vinay11hariharan-bit/IM-PULSE/reports/MON-04-M2.pdf

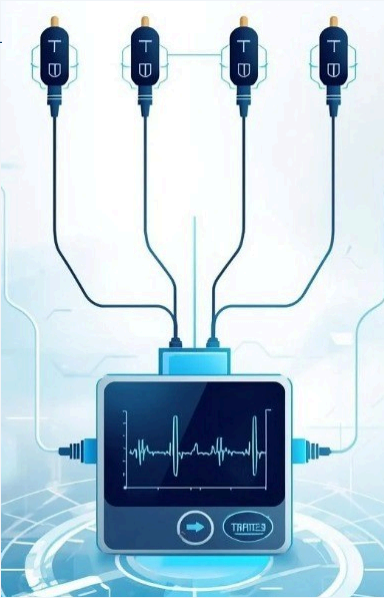
[picture p15: figure]

# Milestone 2

# Simultaneous Measurement of IPGand ECGusing dry Electrodes

# Group ID:MON-04

Team Members- Yashvardhan,

# Krunal, Sudhindra, Vinay,Jahnvi

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
## ple

t

e

d

w

a

s

w

## ell-

received and found to cover most aspects. We were advised to further validate that decisions regarding the number and placement of electrodes are well-justified. Two areas were identified for additional work:Incorporating the necessary interfacing components for the external oscillator Researching appropriate testing methods, as direct testing on humans may not be safe.Feedback

Fin

aliz

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
d: 5

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
al-IP

G

a

c

q

uisitio

n. Included an external oscillato r
alo

n

g

wit

h it

s

r

e

q

uir

e

d interfacing component
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
timin

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
n. Selected a
sin

gle implementation
a

p

p

r

o

a

c

h: chip-based architecture usin g
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
al A

F

E IC

s instead of discrete analog design. Adopted thorax impedance simulator as a testing tool for validating impedance measurement accuracy befor

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
# g. Changes

m

a

d

e

# Gantt chart

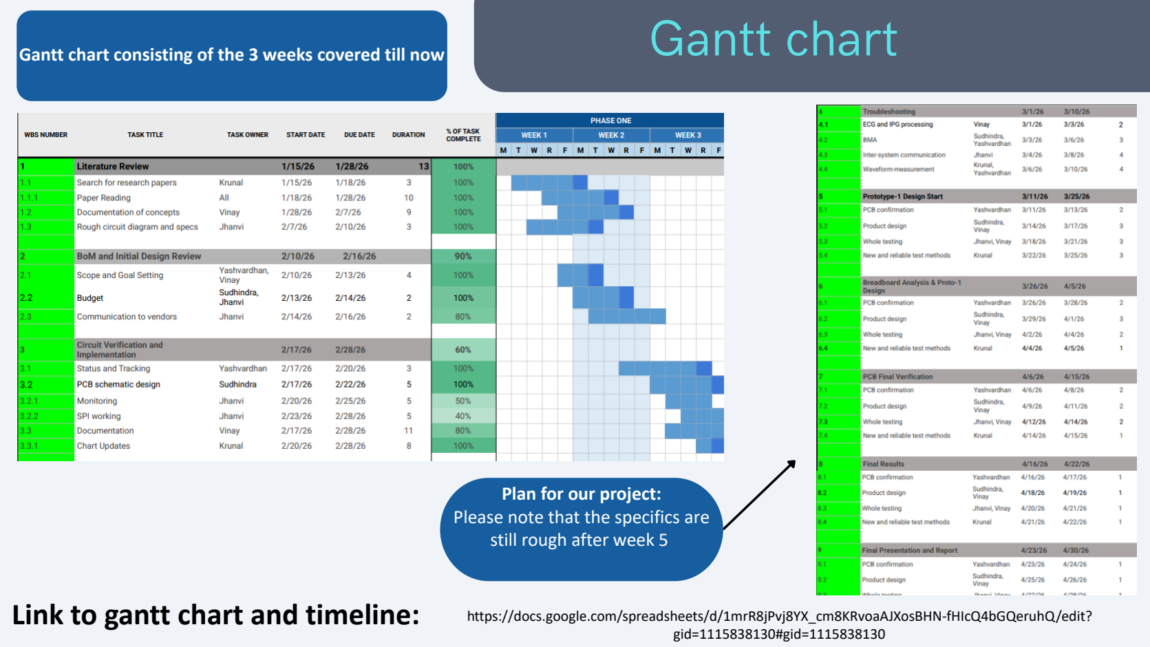
[picture p16: page 3]

Plan for our project:
Please note that the specifics are still rough after week 5

Gantt chart consisting of the 3 weeks covered till now

https://docs.google.com/spreadsheets/d/1mrR8jPvj8YX_cm8KRvoaAJXosBHN-fHIcQ4bGQeruhQ/edit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

## Link to gantt chart and timeline:

# Timeline

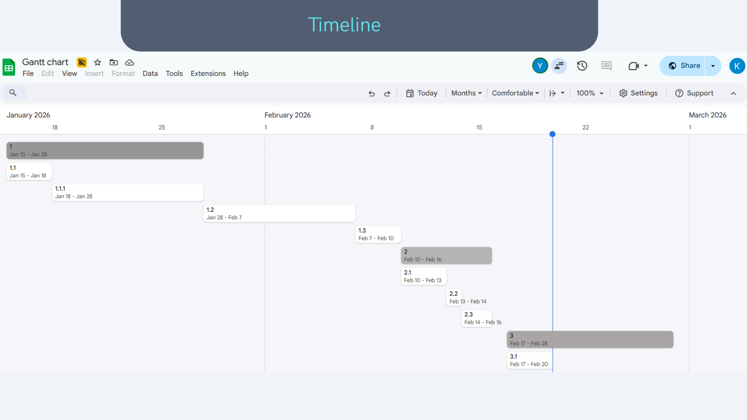
[picture p17: page 4]

# Timeline

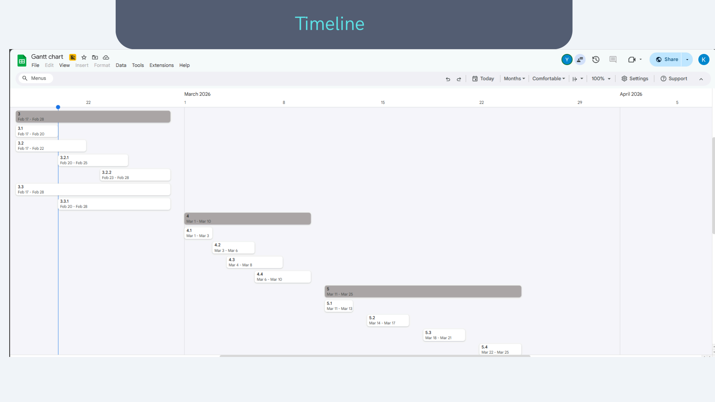
[picture p18: page 5]

# Timeline

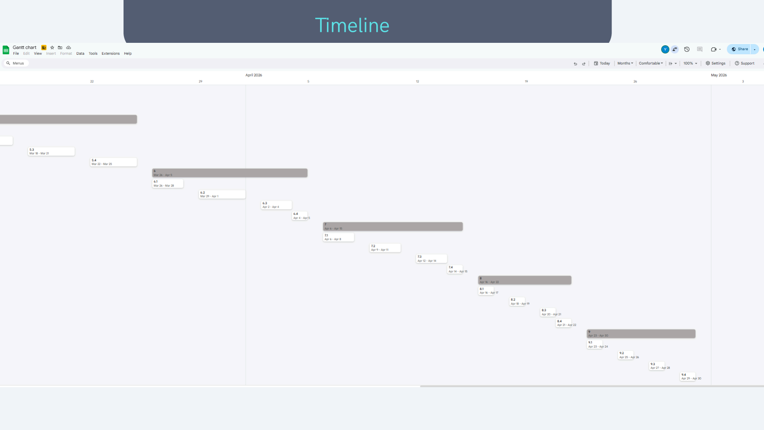
[picture p19: page 6]

Hardware Decisions | Testing Protocol | Accuracy Concerns | Timeline Impact

Our initial design featured four electrodes per chip integrated into a custom PCB. However, following a Bill of Materials (BOM) review with the
research/teaching assistants and Maheshwar Sir, we pivoted away from direct chip integration due to the technical difficulties of soldering BGA (Ball Grid Array) packages. Per their advice, we are now utilizing breakout boards. This modification reduces the available pins to three electrodes per chip (including the RLD drive); consequently, our dual-chip configuration will now utilize a total of five electrodes.

While we originally
intended to conduct
human subject testing, we
have shifted to using a
proxy (e.g., a signal
generator or phantom) to
address safety concerns.
(as suggested by
Himanshu Sir)

Due to simultaneous
current injection and
voltage measurement, the
quality of the measured
IPG signal will also
degrade, as PC Pandey Sir
pointed out to us.

We are currently behind
the original Gantt chart
schedule. The "System-on-Chip" testing phase has
been delayed due to the
late delivery of the
integrated circuits, which are critical components of our system.

# Changes made against gantt chart

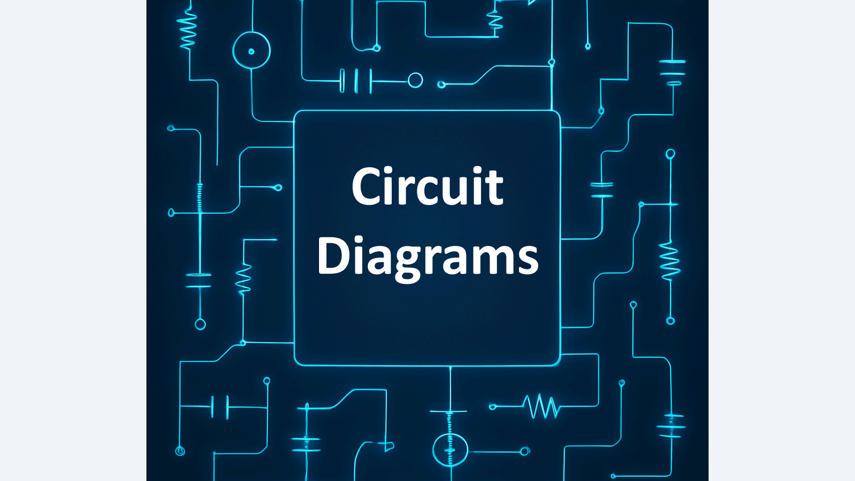
[picture p20: page 8]

# Circuit Diagrams

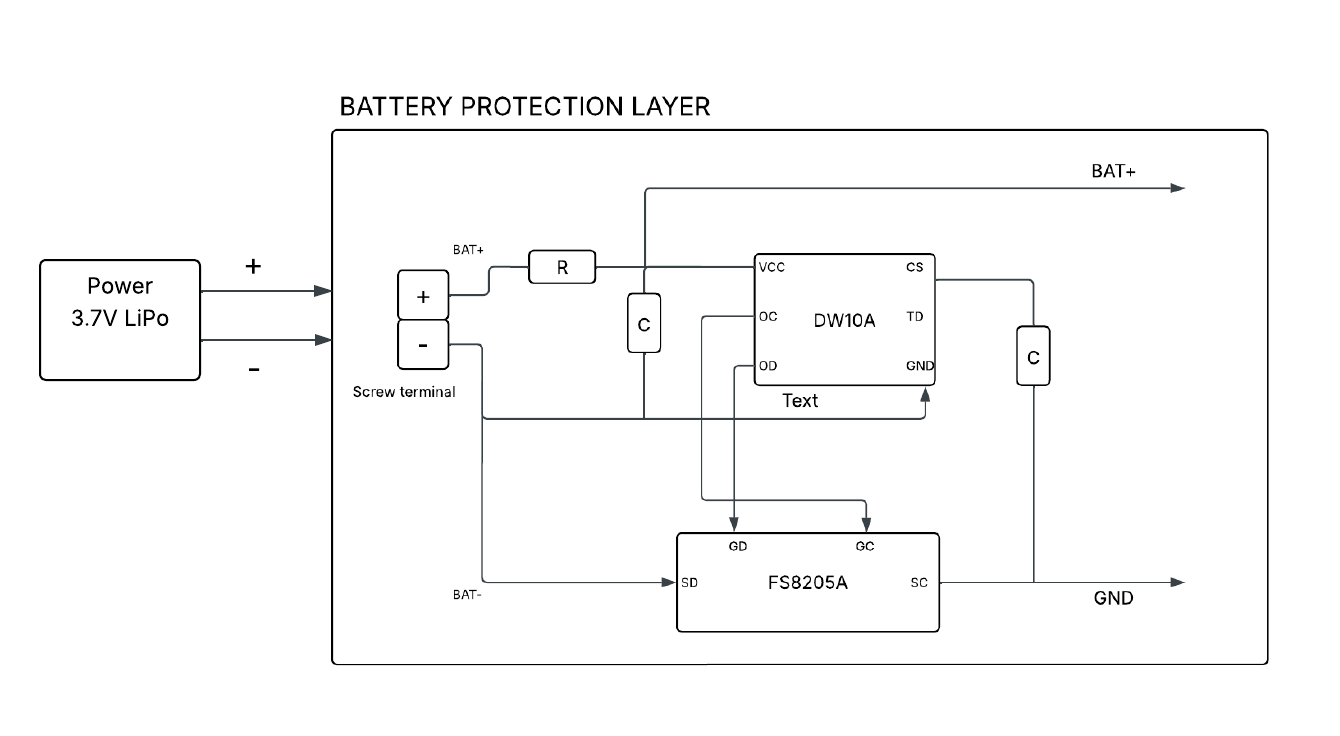
[picture p21: page 9]
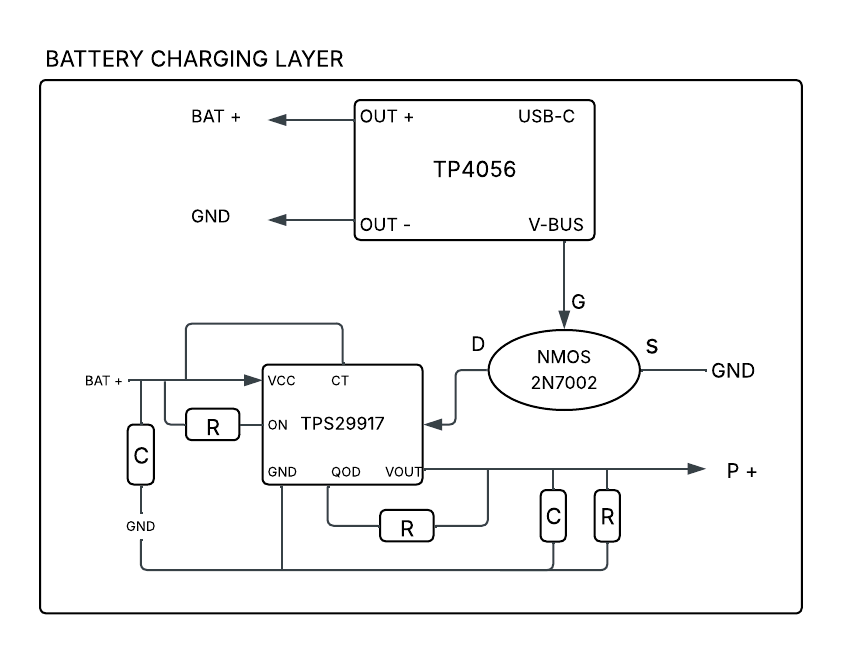
[picture p22: page 10]
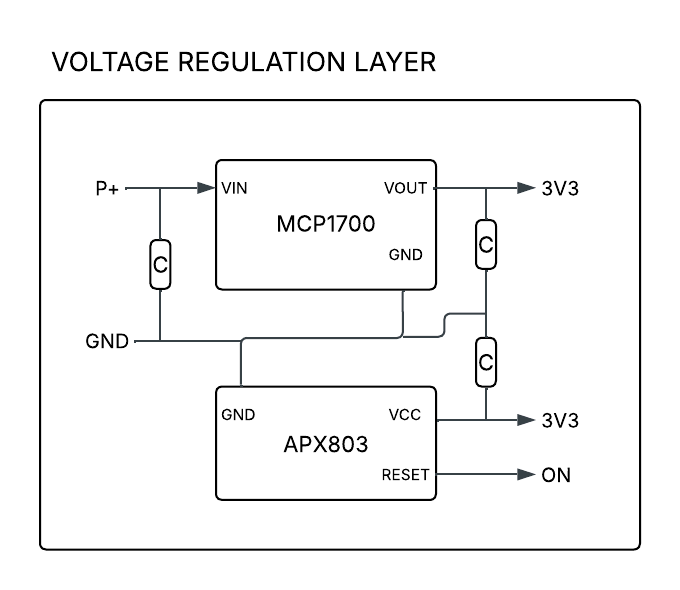
[picture p23: page 11]
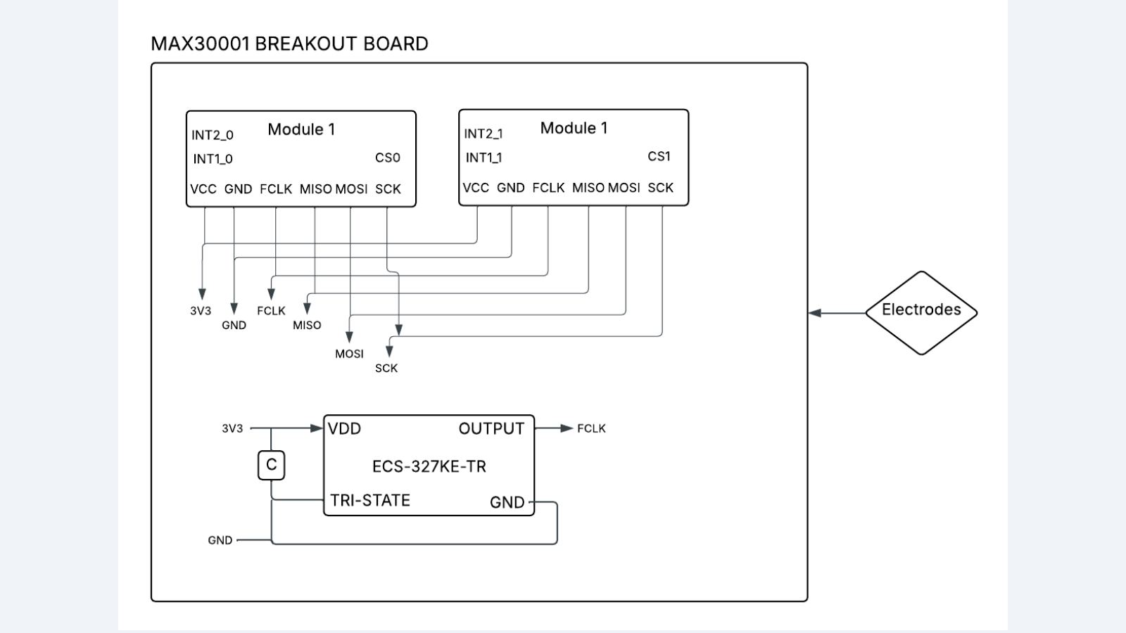
[picture p24: page 12]
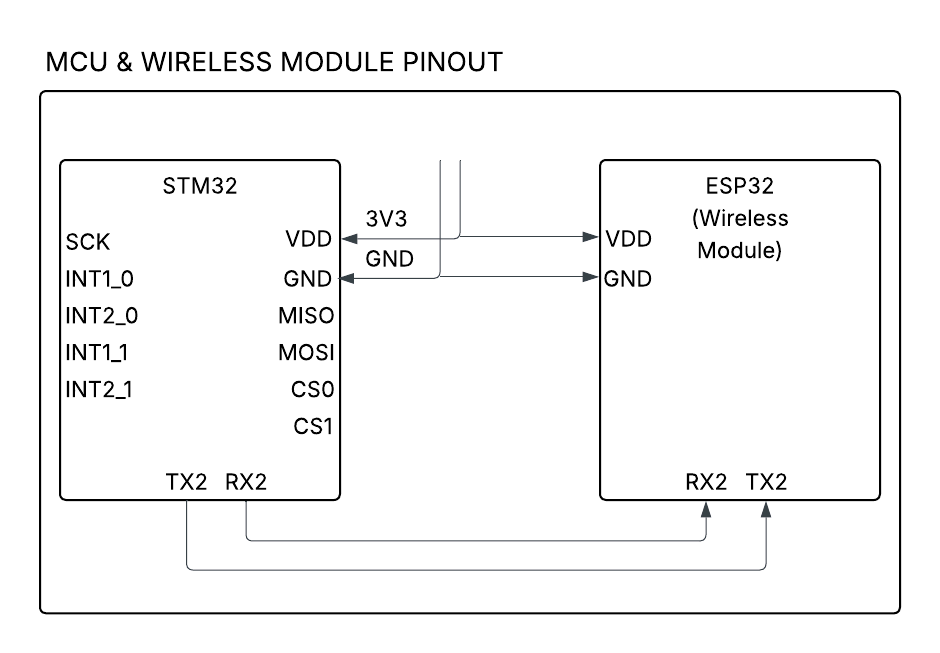
[picture p25: page 13]
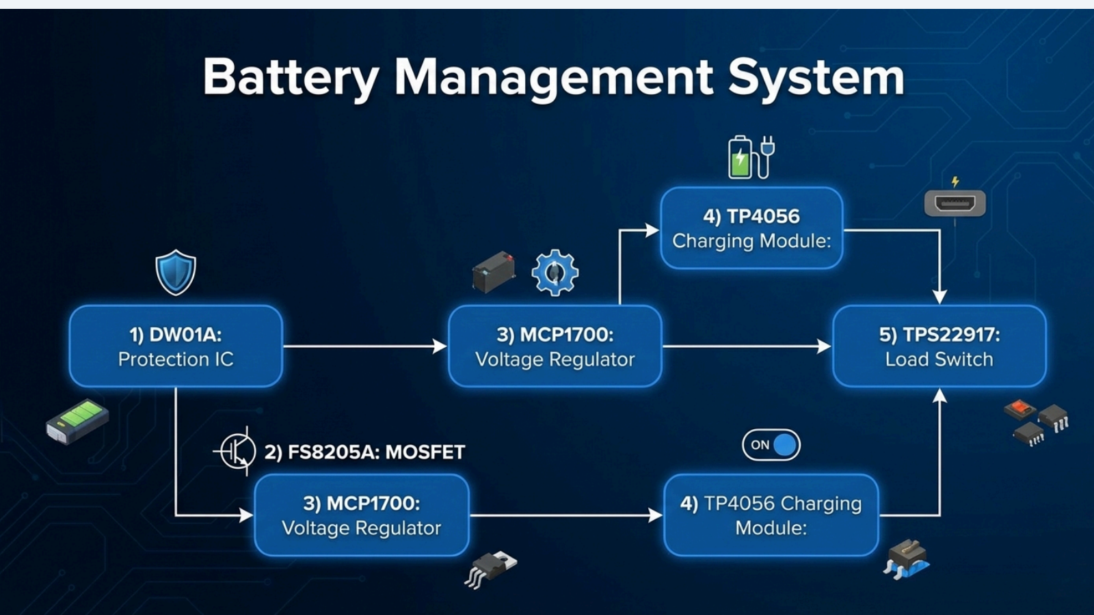
[picture p26: page 14]
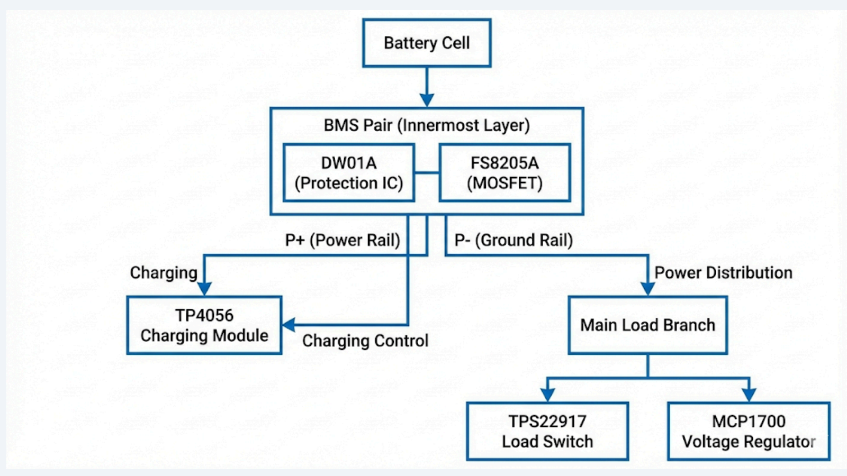
[picture p27: page 15]

# 1) DW01A:

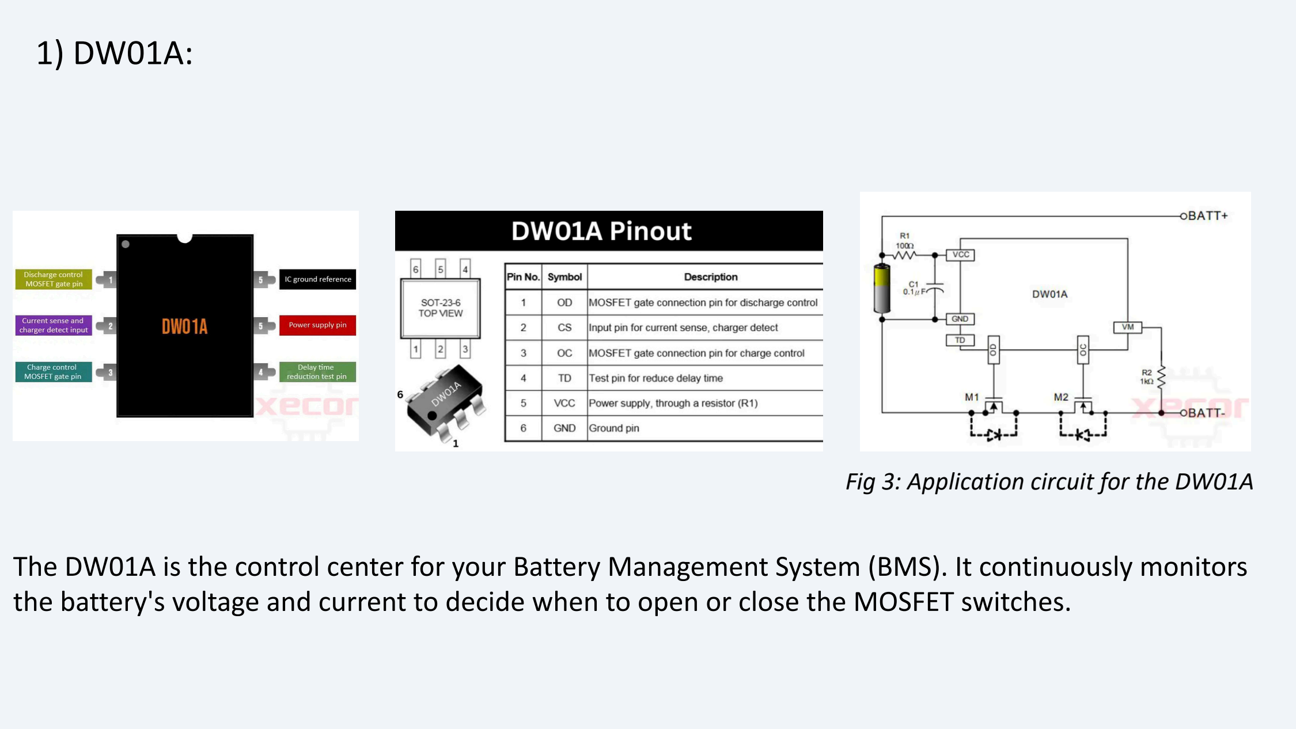
[picture p28: page 16]

The DW01A is the control center for your Battery Management System (BMS). It continuously monitors the battery's voltage and current to decide when to open or close the MOSFET switches.

### Fig 3: Application circuit for the DW01A

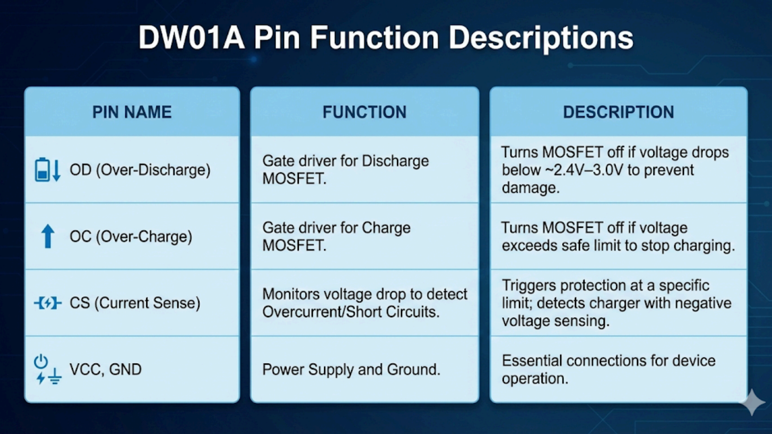
[picture p29: page 17]

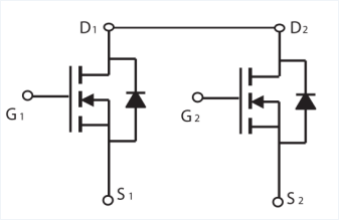
[picture p30: figure]
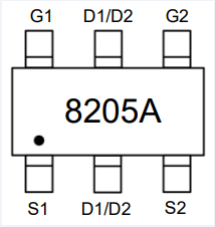
[picture p31: figure]
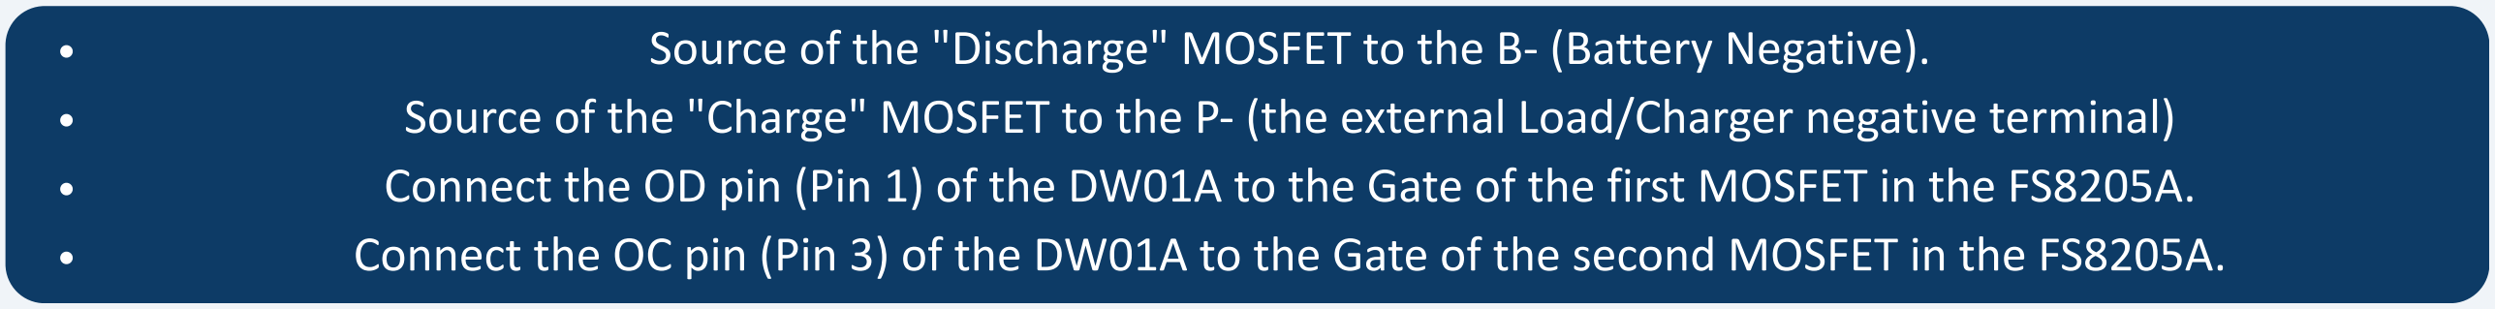
[picture p32: figure]

Source of the "Discharge" MOSFET to the B- (Battery Negative). Source of the "Charge" MOSFET to the P- (the external Load/Charger negative terminal) Connect the OD pin (Pin 1) of the DW01A to the Gate of the first MOSFET in the FS8205A. Connect the OC pin (Pin 3) of the DW01A to the Gate of the second MOSFET in the FS8205A.

# 2) FS8205A:

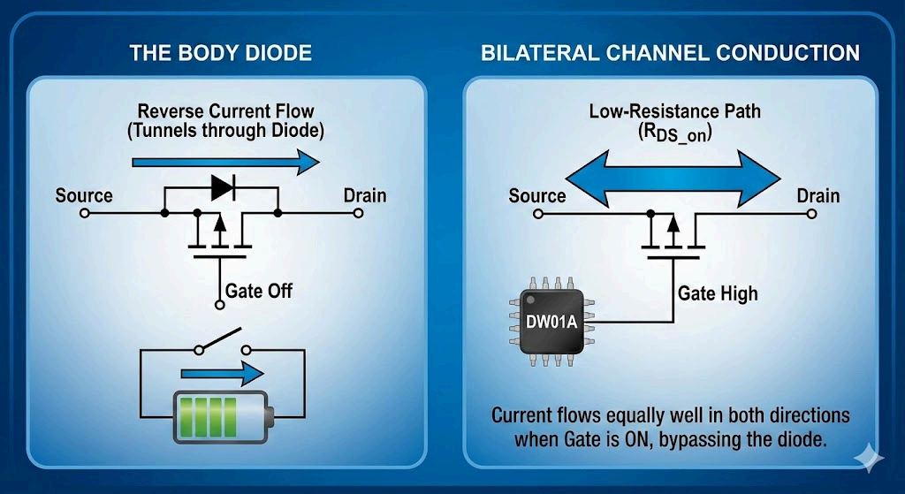
[picture p33: page 19]

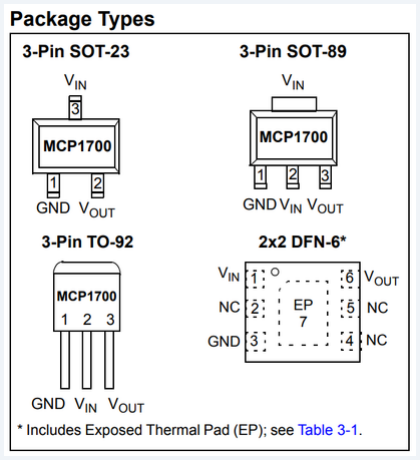
[picture p34: figure]
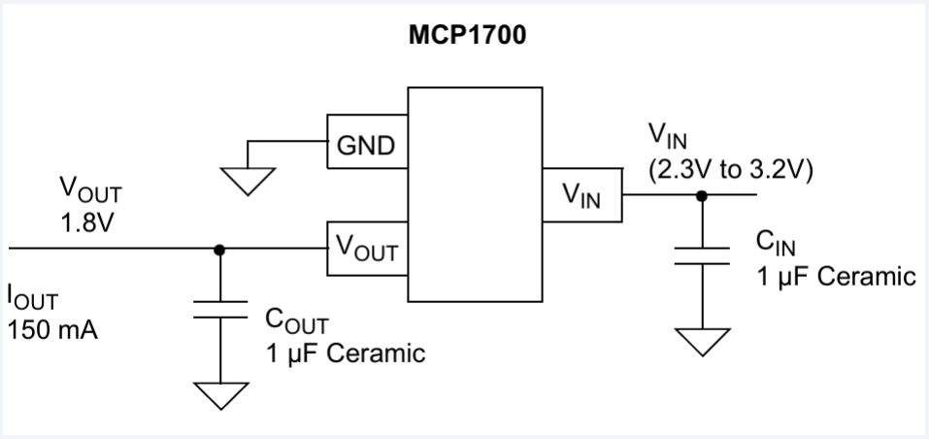
[picture p35: figure]
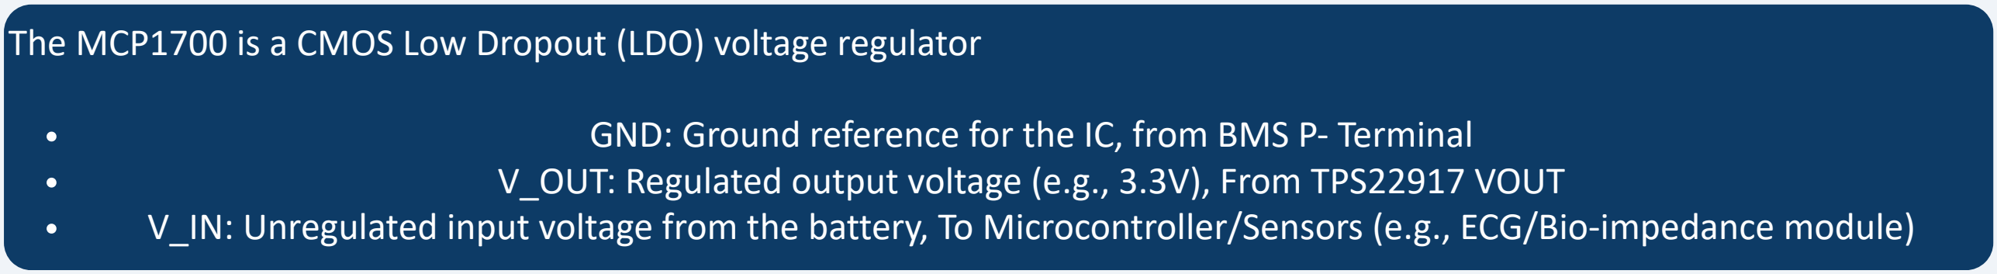
[picture p36: figure]

The MCP1700 is a CMOS Low Dropout (LDO) voltage regulator

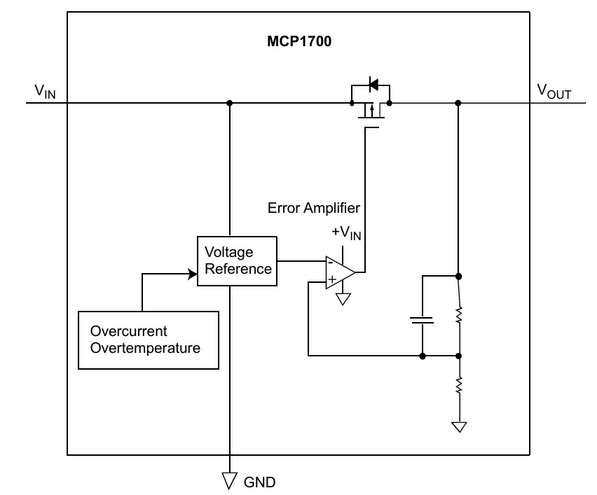
[picture p37: figure]

GND: Ground reference for the IC, from BMS P- Terminal V_OUT: Regulated output voltage (e.g., 3.3V), From TPS22917 VOUT V_IN: Unregulated input voltage from the battery, To Microcontroller/Sensors (e.g., ECG/Bio-impedance module)

## 3) MCP1700:

# 4) TP4056 Charging module:

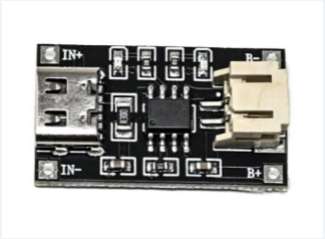
[picture p38: figure]
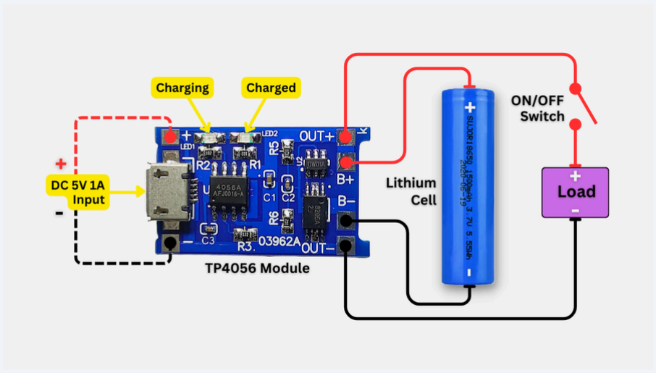
[picture p39: figure]

## Charging Module (TP4056): Connect the BAT+ and BAT- pins of the TP4056 directly to the

P+ and P- terminals the BMS.
Note: Do not connect the TP4056 directly to the battery cell; it must sit "outside" the BMS so the protection IC can cut off the charger if it malfunctions.

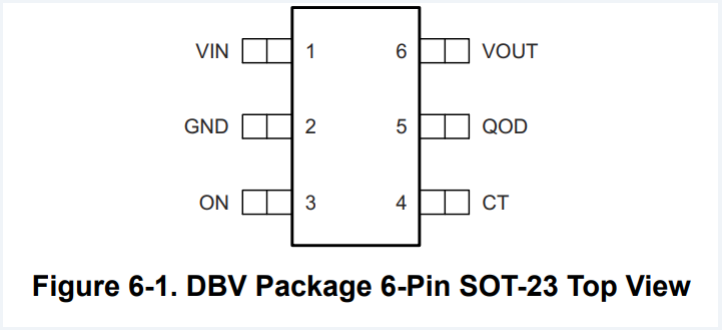
[picture p40: figure]

Implementing the "Disconnect while Charging" Logic

Input Power: Connect P+ (from BMS) to the VIN of the TPS22917.
Control Signal (ON Pin): The TPS22917 "ON" pin is active high. To turn the circuit OFF when a charger is plugged in, we need to "pull down" this pin when voltage is detected at the TP4056 VBUS/USB IN.
Simple Logic: We can use a small NPN transistor or a P-channel MOSFET. Connect the gate/base to the TP4056 input 5V. When 5V is present (charging), the transistor pulls the TPS22917 ON pin to Ground, opening the circuit.
Output to Regulator: Connect the VOUT of the TPS22917 to the VIN of the MCP1700 LDO.

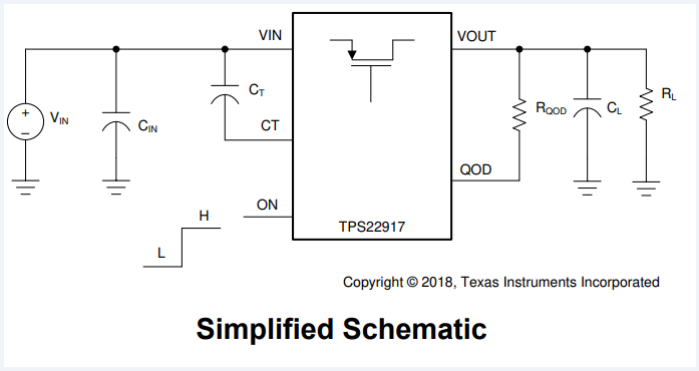
[picture p41: figure]

Description of useful pins: V_OUT: Switched output voltage to the MCP1700 regulator.
GND: Ground reference for the IC.
ON: Active-high enable pin. High = V_{IN} connected to V_{OUT}; Low = Disconnected. V_{IN}: Input voltage from the P+ terminal of the BMS.
CT: Charge Time control. Connect a capacitor here to set the "soft-start" (slew rate).
QOD: Quick Output Discharge. Connect to $V_{OUT}$ to drain the line fast when switched off

## 4) TPS22917:

how to put it in the PCB

# Battery Protection vs. System Stability: The "Brownout Gap"

BMS Cut-off: The DW01A typically cuts power at 2.4V to prevent permanent battery damage.
LDO Dropout: For a 3.3V output, the MCP1700 requires an input of at least ~3.48V due to its dropout voltage.
System Failure: Between 3.4V and 2.4V, the regulator output drops, causing MCU instability, sensor errors, or data corruption in projects like your health monitors or robotic arms.

### 1) Software-Based Monitoring (Internal ADC)

Use a voltage divider to scale the battery voltage and read it via the MCU’s Analog-to-Digital Converter (ADC).
Program a "Soft Cut-off" threshold (e.g., 3.4V).
Allows the MCU to perform a graceful shutdown (saving data to EEPROM or sending a final "Low Battery" alert) before the voltage becomes unreliable.

### 2) Hardware Supervisor (External Reset IC)

Add a dedicated Voltage Supervisor IC (e.g., APX803) to monitor the 3.3V rail.
If the rail dips below a safe threshold (e.g., 3.0V), the supervisor pulls the TPS22917 "ON" pin or the MCU Reset pin low. Provides instant, failsafe protection that does not rely on software logic, ensuring the system never runs in an undefined "glitch" state.

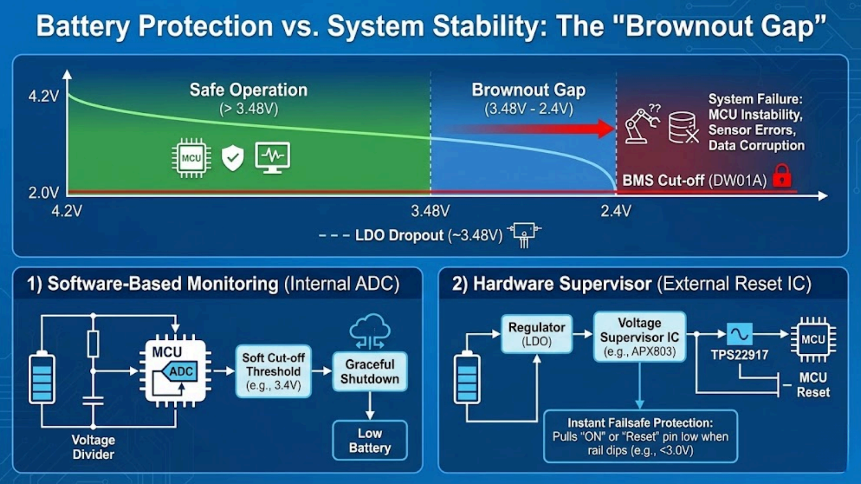
[picture p42: page 24]

## MAX30001 Breakout kit

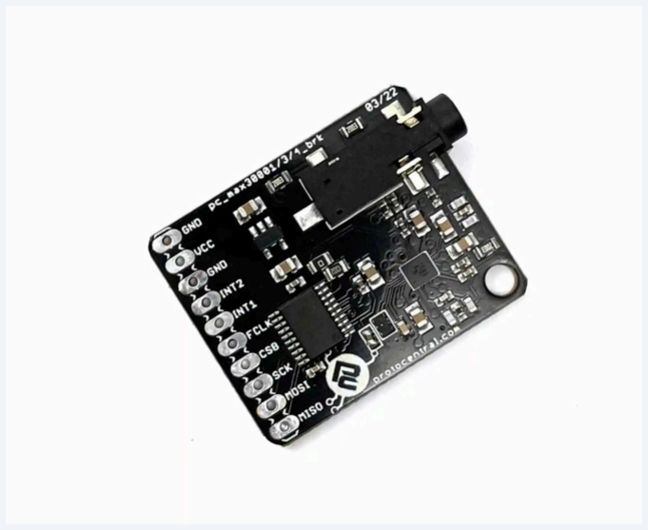
[picture p43: figure]

The MAX30001 is a high-performance Analog Front-End (AFE) designed for clinical-grade ECG and bio-impedance (BioZ) measurements.
VCC: Main analog supply pin. It is typically connected to 5V to power the internal analog circuitry.
3V3: Digital logic supply pin. It connects to a regulated 3.3V rail (for example, from an MCP1700) to match the MCU’s logic levels.
GND: Common ground reference used for both power return and signal reference.
MISO (Master In Slave Out): SPI data output pin. It sends digitized ECG and BioZ data from the MAX30001 to the microcontroller.
MOSI (Master Out Slave In): SPI data input pin. It receives configuration commands and control data from the microcontroller.
SCK (Serial Clock): SPI clock signal. It synchronizes data transfer timing between the MAX30001 and the microcontroller.
CS0 (Chip Select): Active-low SPI select pin. The microcontroller pulls this low to start communication with the MAX30001.
INT1 / INT2: Programmable interrupt output pins. These notify the microcontroller about events such as lead-off detection, FIFO buffer full, or R-to-R heart rate detection.
FCLK: External clock input pin. It allows a precise external frequency reference to be provided if the internal oscillator is not sufficient.

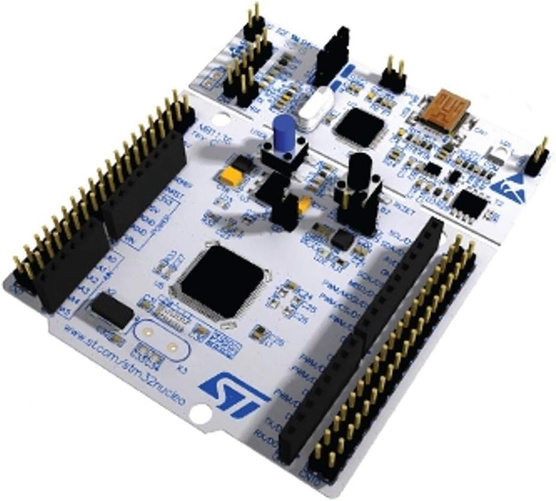
[picture p44: figure]

MAX30001 Pin | Nucleo Connector Pin | STM32 GPIO Pin | Function
VCC | 5V | 5V | Analog Power (5V)
3V3 | 3V3 | 3V3 | Digital Logic (3.3V)
GND | GND | GND | Common Ground
MISO | D12 | PA6 | SPI1 MISO
MOSI | D11 | PA7 | SPI1 MOSI
SCK | D13 | PA5 | SPI1 SCK
CS0 | D10 (or D7) | PB6 | Hardware/Software CS
INT1 | D2 | PA10 | External Interrupt (EXti)

## STM32 Nucleo Board

When configuring the project in STM32CubeIDE,we need to use these settings for the SPI1 peripheral to match the MAX30001 requirements:
Mode: Full-Duplex Master.
Frame Format: Motorola.
Data Size: 8 Bits.
Clock Polarity (CPOL): Low (CPOL = 0).
Clock Phase (CPHA): 1 Edge (CPHA = 0).
Baud Rate: The MAX30001 supports up to 20MHz, but for stable breadboard testing, start around 5-10 MHz.

## ESP32-DEVKIT (Wireless Module)

We would establish a dedicated high-speed data path by cross-connecting STM32 UART2 (TX: PA3/CN10

_

37, RX: PA2/CN10

_

35) to ESP32 UART2 (RX: GPIO16, TX: GPIO17). This configuration isolates the raw medical data stream from the primary USB-to-Serial debug port (UART0 of ESP32).

We bypass the ESP32’s onboard regulator and dropout losses by connecting the regulated 3.3V rail directly to the 3V3 pin instead of the Vin pin.

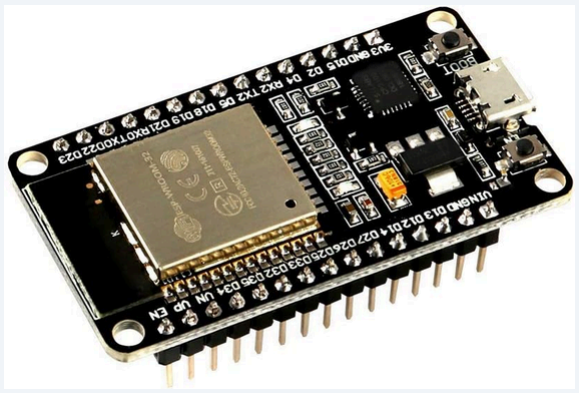
[picture p45: figure]
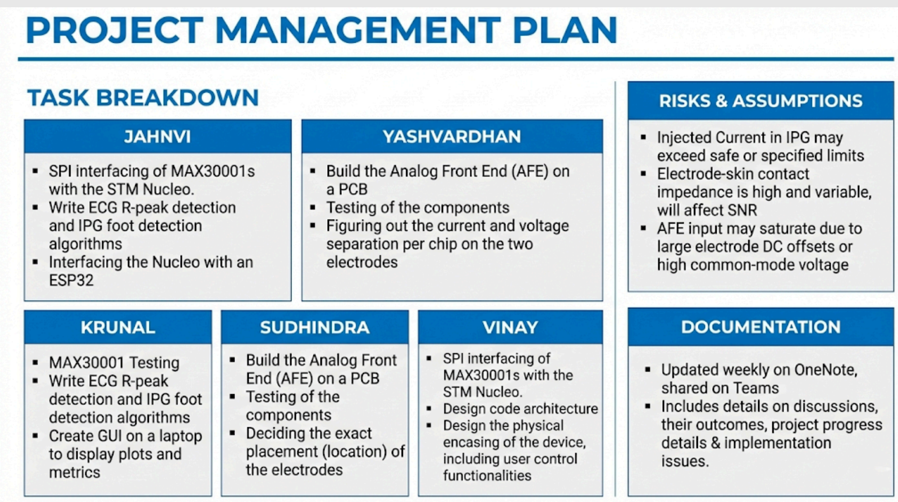
[picture p46: page 28]

# BLOCK DIAGRAM

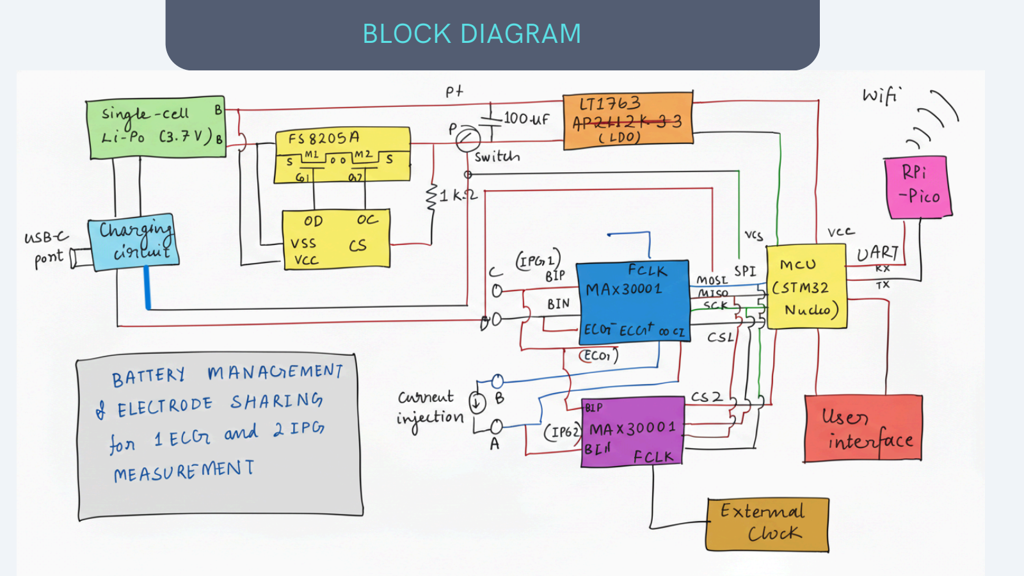
[picture p47: page 29]
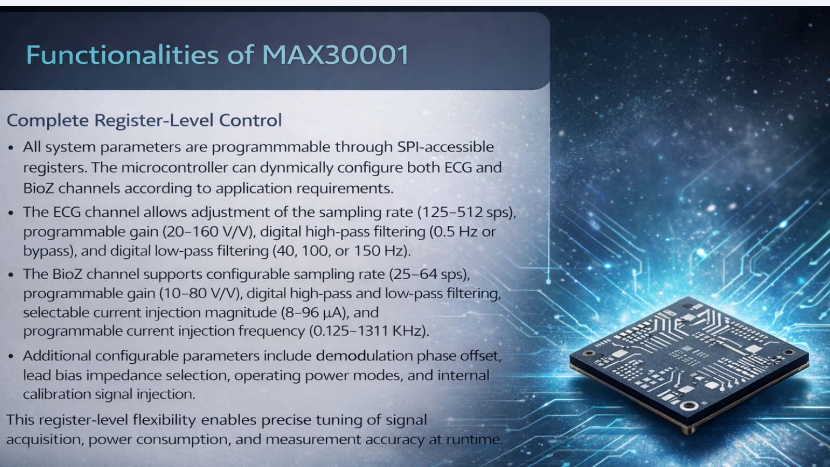
[picture p48: page 30]
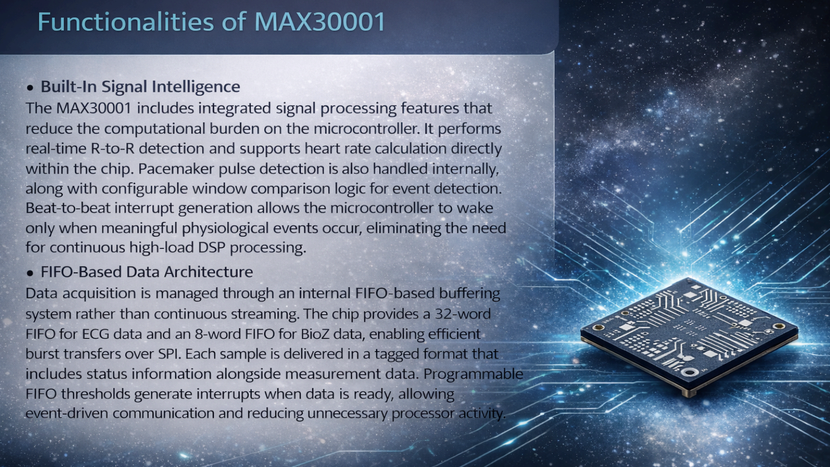
[picture p49: page 31]
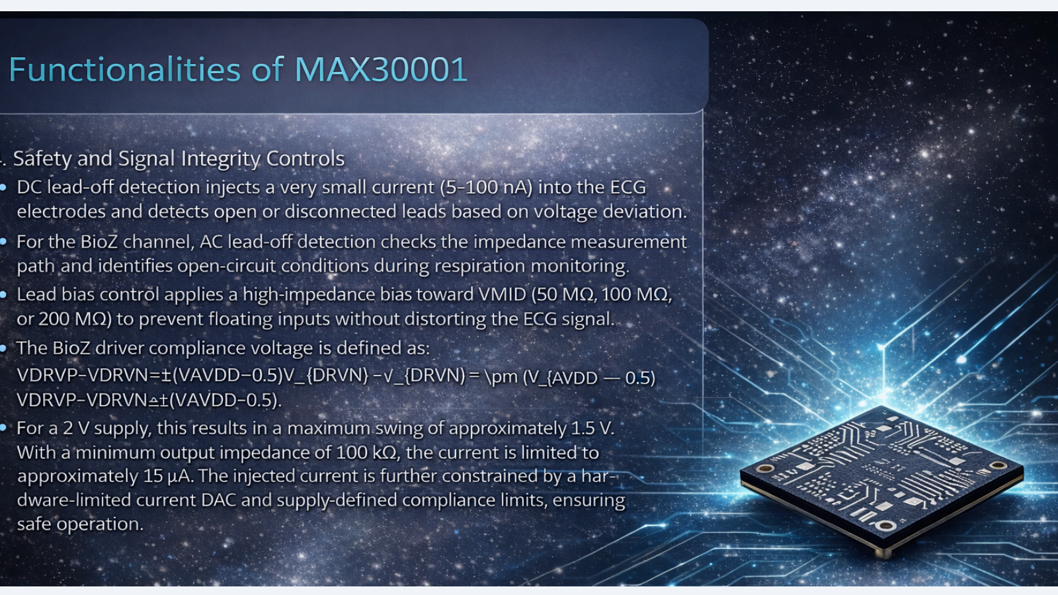
[picture p50: page 32]
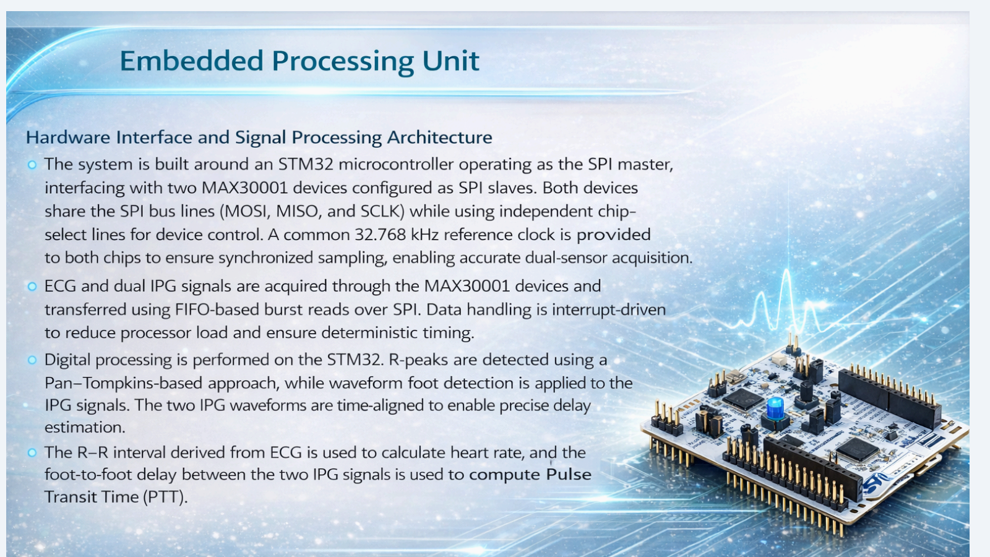
[picture p51: page 33]
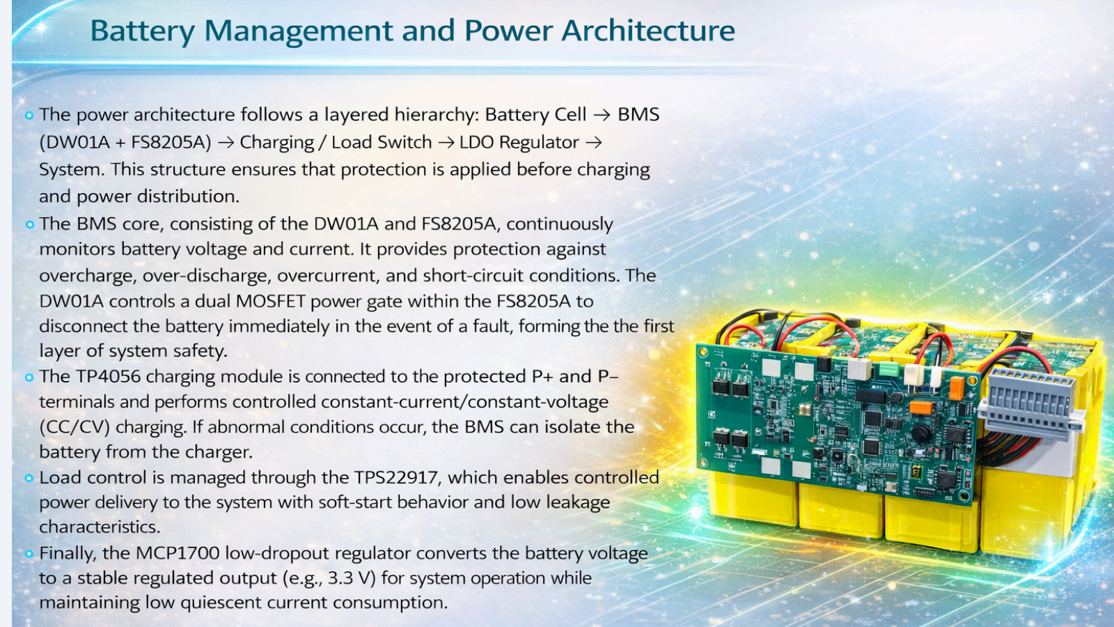
[picture p52: page 34]
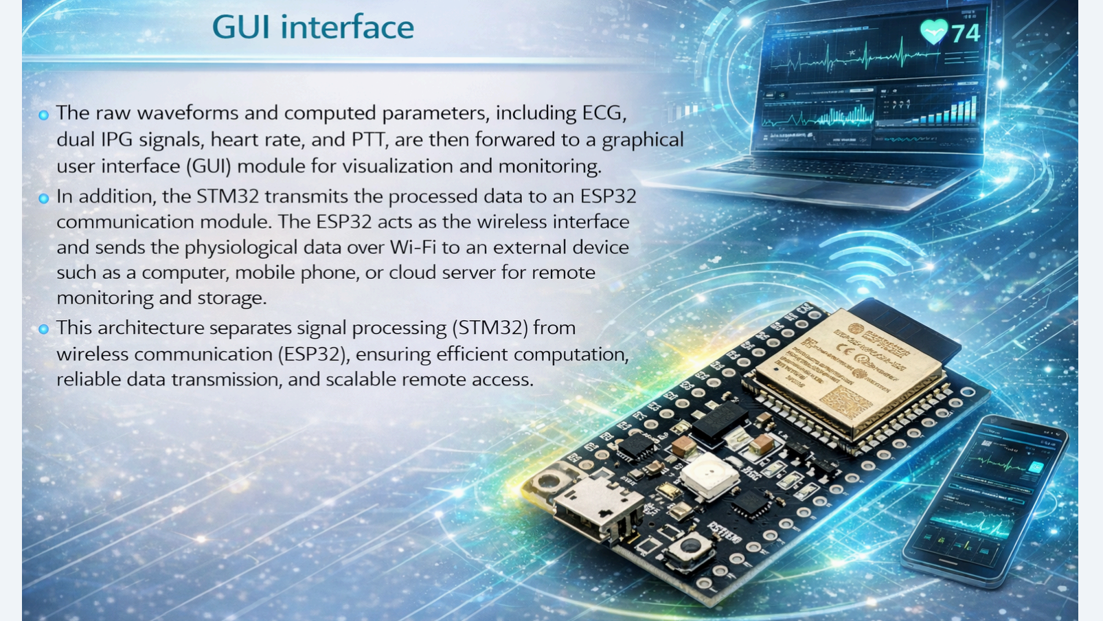
[picture p53: page 35]
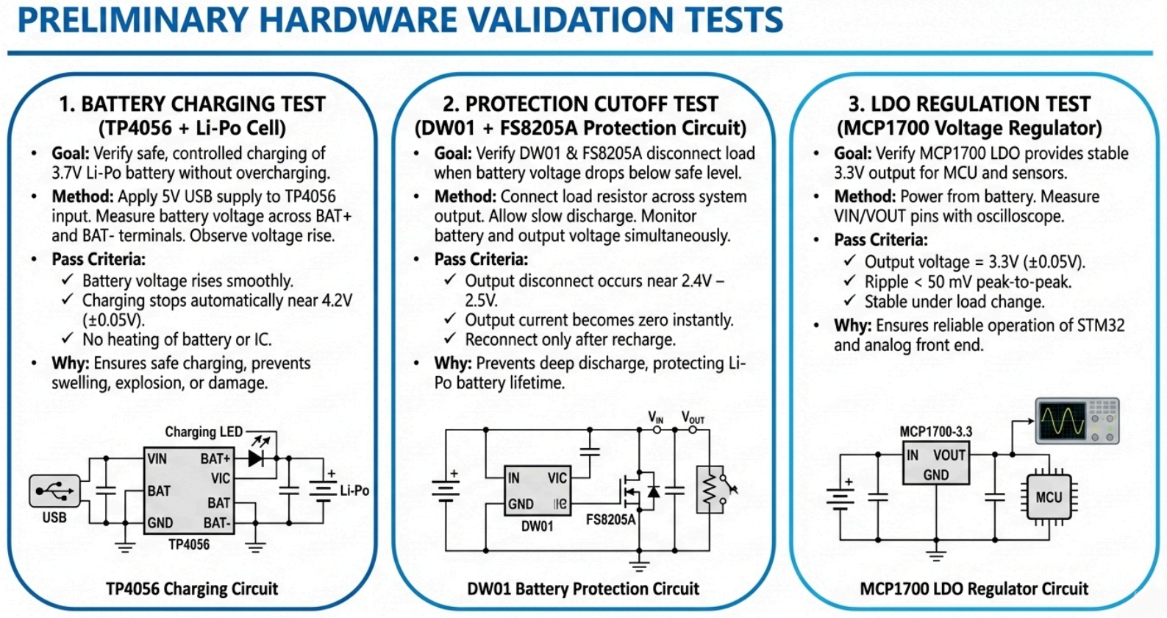
[picture p54: page 36]
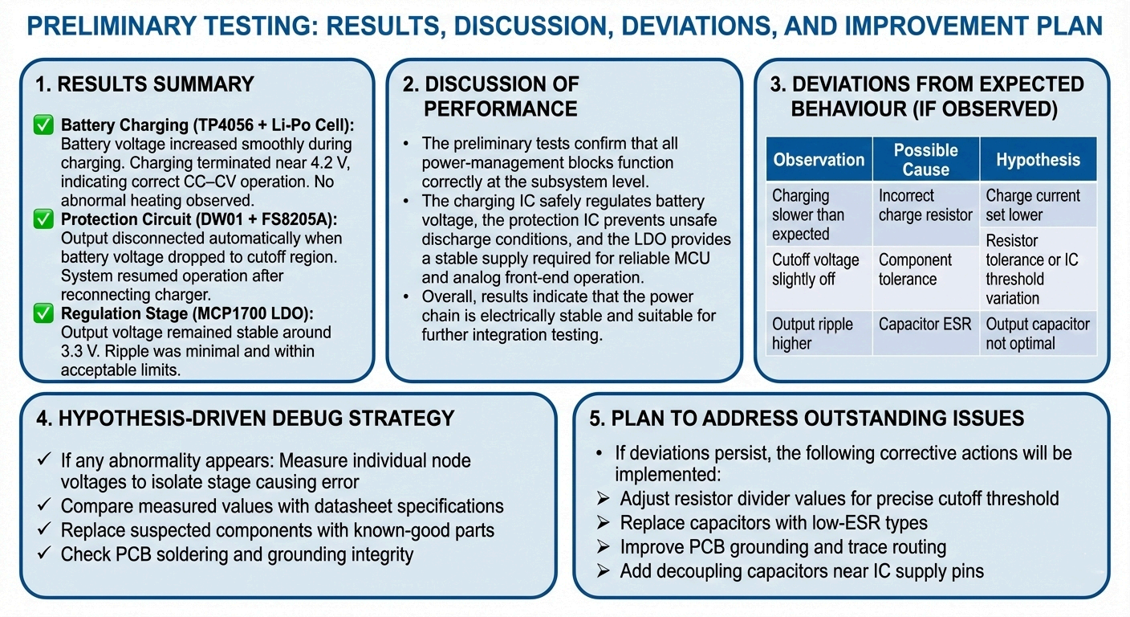
[picture p55: page 37]
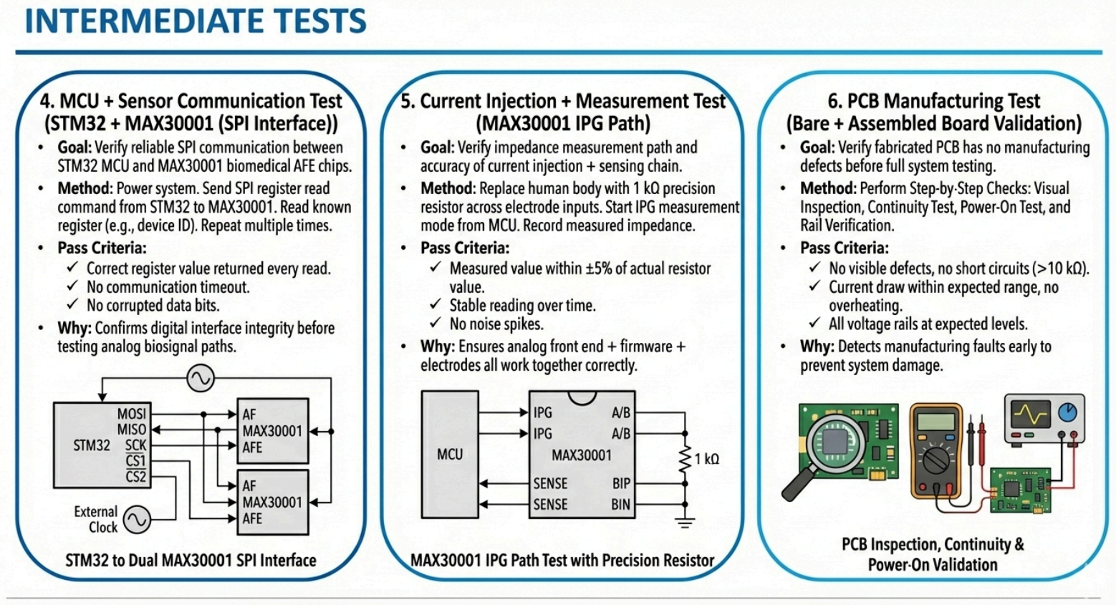
[picture p56: page 38]
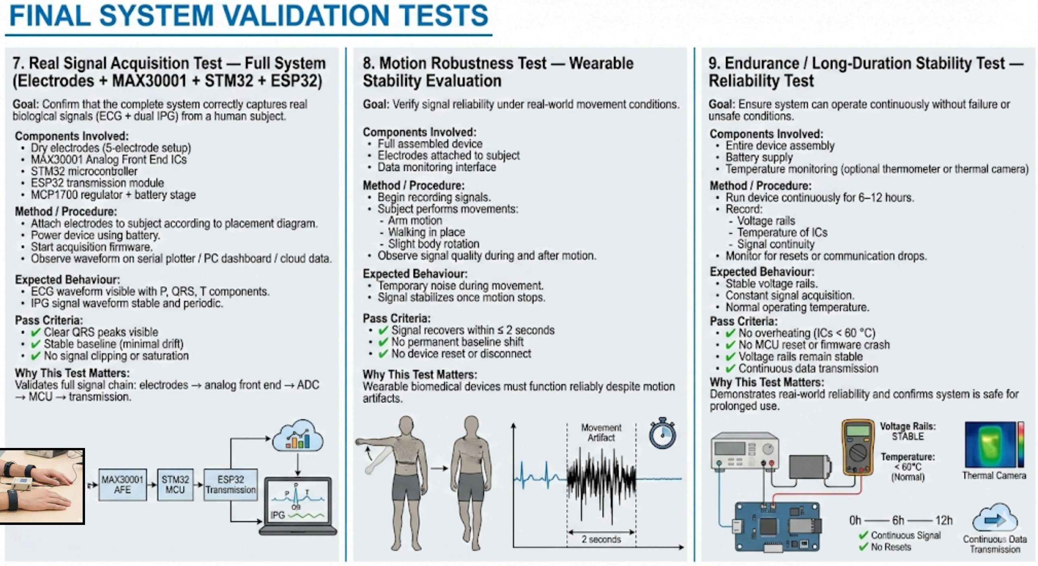
[picture p57: page 39]

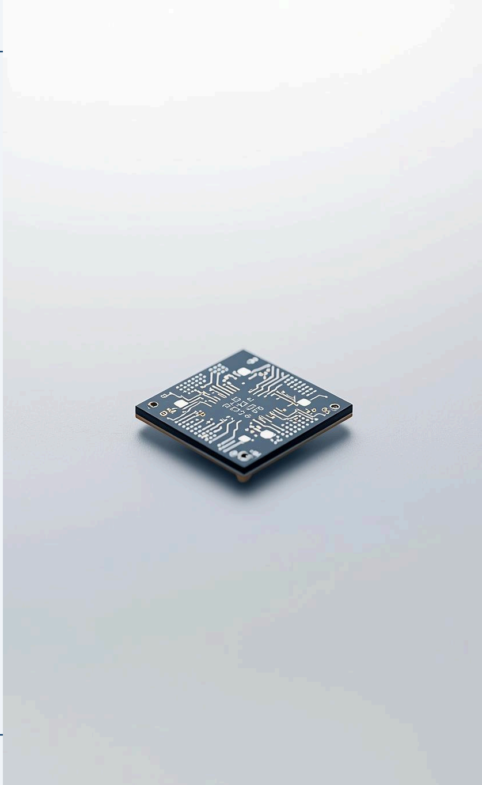
[picture p58: figure]

# Thinking ahead to the nextmilestone

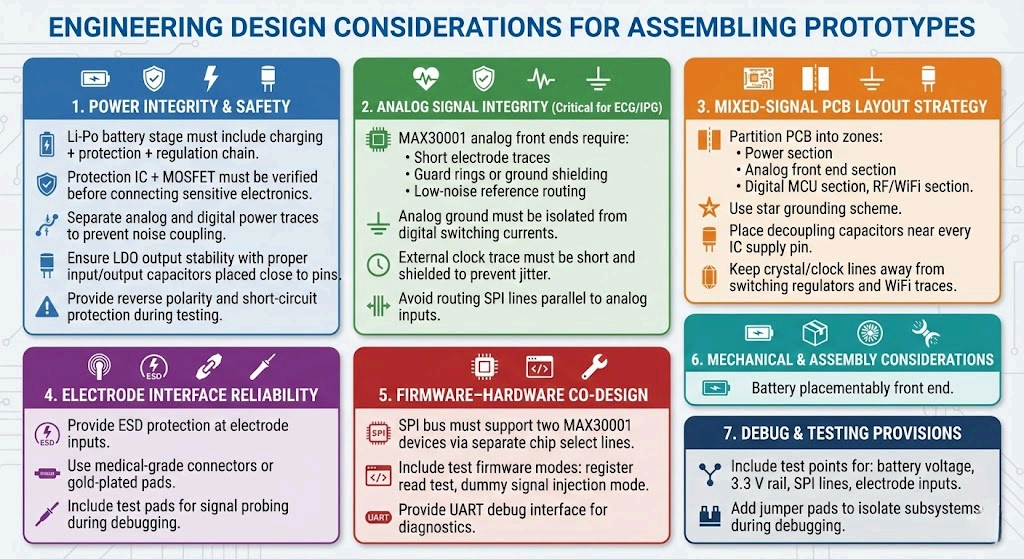
[picture p59: page 41]
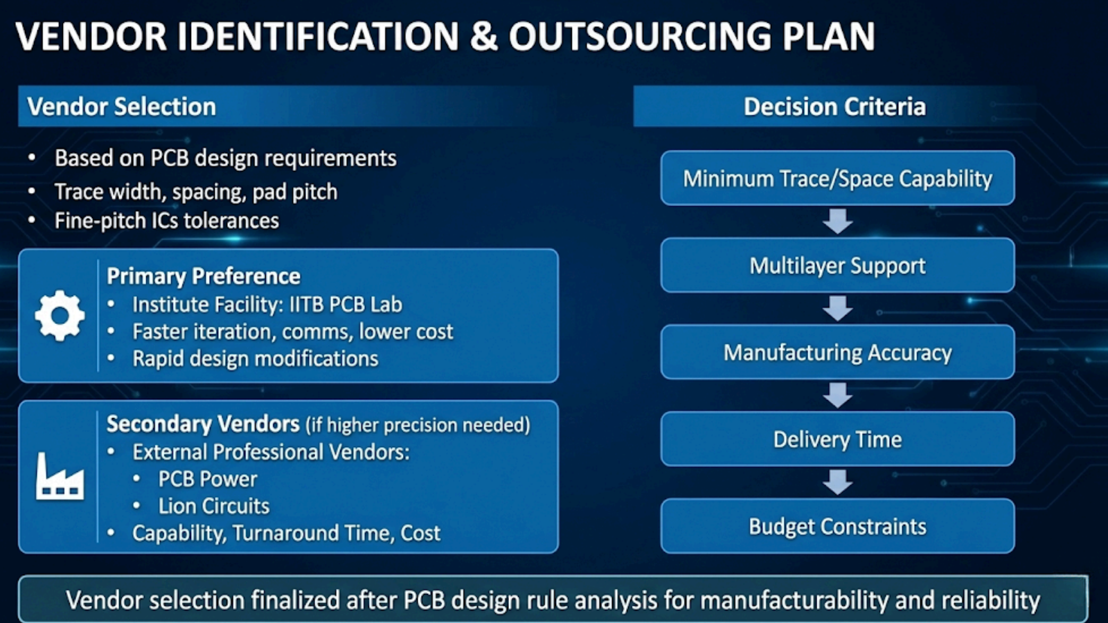
[picture p60: page 42]

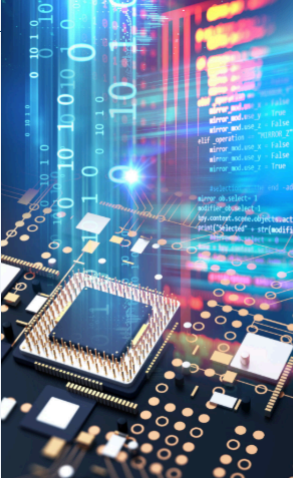
[picture p61: figure]

# SystemSoftware

# Some Design Decisions and Rationale:

## RTOS: ensures deterministic sampling (ECG 256 Hz, IPG 128 Hz), ms-accurate timestamps for PTT, and priority-based execution so acquisition and processing always preempt

communication and UI tasks.

## RTOS Choice (vs Zephyr): selected FreeRTOS for lower RAM/Flash usage, simpler STM32 integration, and sufficient

real-time features without unnecessary complexity.

## No DMA: data transfers are small and interrupt-based drivers

reduce system complexity.

## Logic Analyzer for Debugging: enables verification of SPI timing, chip-select sequencing, and interrupt behavior that

cannot be reliably observed via software debugging alone.

# Code Architecture

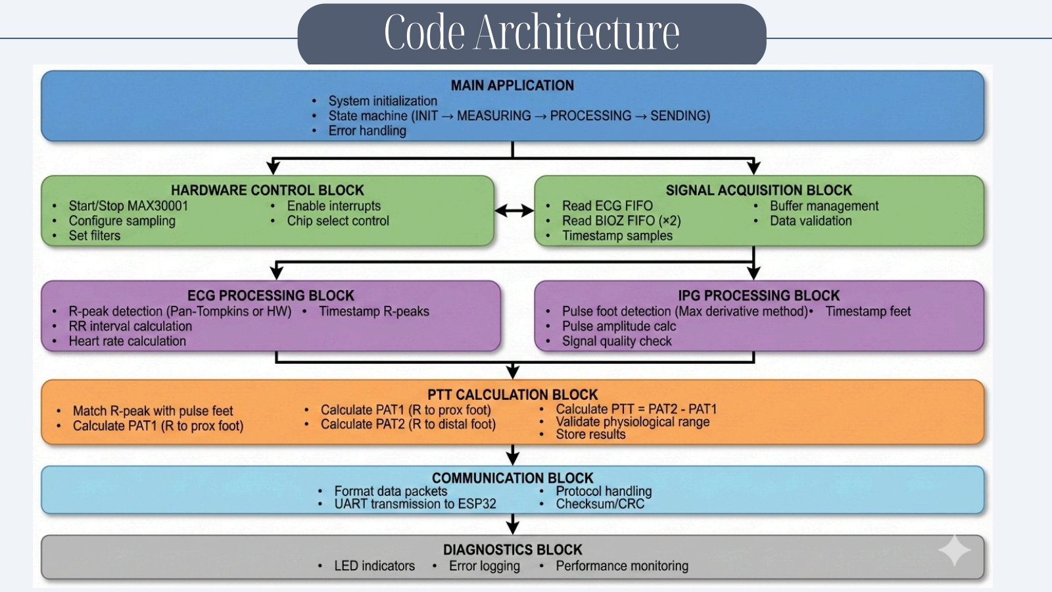
[picture p62: page 44]

# Simulation:R-peak detectionalgorithm

## The algorithm is a linear signal processing pipeline in which each stage

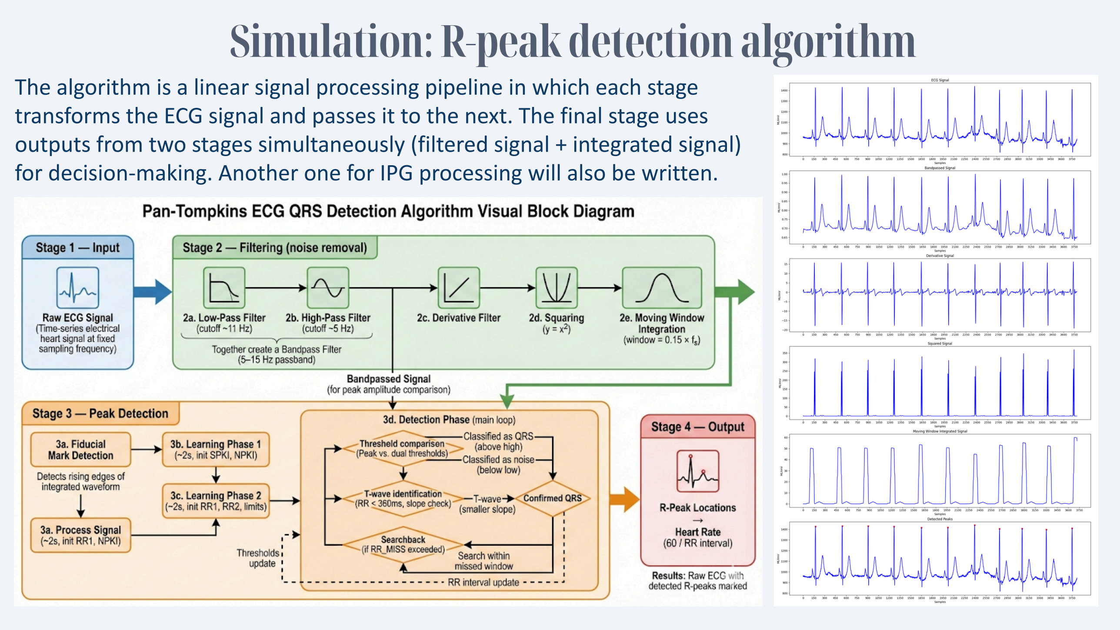
[picture p63: page 45]

## transforms the ECG signal and passes it to the next. The final stage uses outputs from two stages simultaneously (filtered signal + integrated signal)

for decision-making. Another one for IPG processing will also be written.

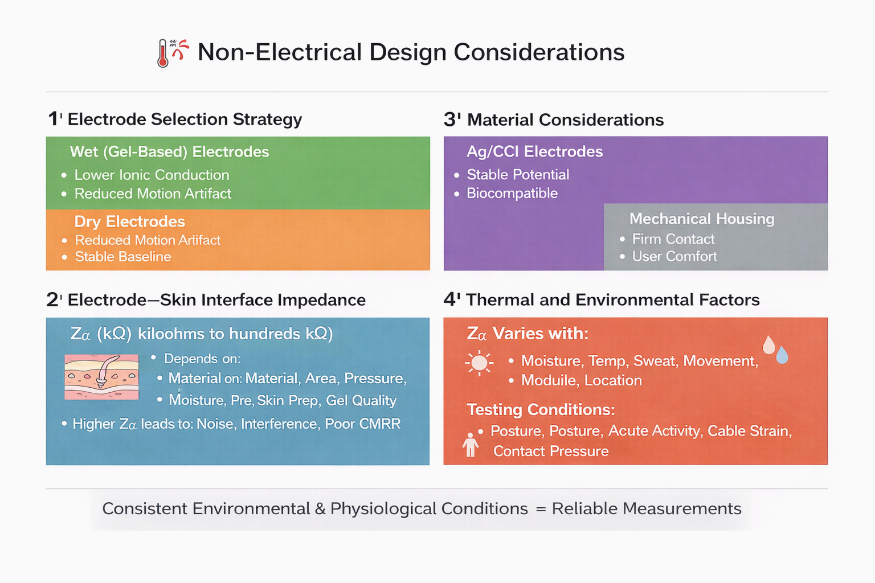
[picture p64: page 46]
