vinay11hariharan-bit/IM-PULSE/others/extra/xgbreg.pdf

## XGBRegressor vs Linear Regression

## XGBRegressor Overview

XGBRegressor (eXtreme Gradient Boosting Regressor) is an efficient implementation of the gradient boosted decision tree algorithm designed specifically for regression tasks. It is part of the XGBoost library, which is widely used in machine learning due to its speed and high performance.

## How it Works

XGBoost is an ensemble method. Instead of fitting a single model to the data, it builds a sequence of simple models (typically decision trees) iteratively:

- The first tree makes an initial rough prediction.
- The second tree focuses on correcting the errors (residuals) of the first tree.
- The third tree focuses on the remaining errors of the previous trees.
- This process continues, with each new tree improving the overall prediction.

## Key Differences from Linear Regression

When referring to “normal” regression, it typically means Ordinary Least Squares (OLS) Linear Regression. The key differences are summarized below:

Feature | Linear Regression (Normal) | XGBRegressor
Relationship | Assumes a linear relationship be-
tween inputs and outputs.

Captures complex, non-linear relationships and feature interactions.
Complexity | High bias (simple model); may
underfit complex data.

High variance (complex model); may overfit if not tuned properly.
Outliers | Highly sensitive to outliers. | More robust to outliers due to
tree-based splitting.
Feature Scaling | Requires feature scaling (e.g.,
normalization) for optimal performance.
Invariant to | feature | scaling;
works well with raw data.

Handling Missing
Data

Cannot handle missing values directly; requires imputation.

Handles missing values automatically using sparsity-aware splitting.
Regularization | Requires | separate | techniques
(Ridge/Lasso) to prevent over-
| fitting.

Includes built-in L1 and L2 regularization.

## When to Use Which?

Use Linear Regression if:

- Interpretability is important.
- You need to understand the exact contribution of each feature.
- The relationship between variables is approximately linear.

Use XGBRegressor if:

- The dataset is large and complex.
- There are non-linear relationships and feature interactions.
- The data contains missing values.
- The primary goal is high prediction accuracy.

## Mathematical Formulation of XGBRegressor

XGBoost models the prediction as an additive ensemble of decision trees. Given a dataset with n samples and m features, the predicted output for the i

th sample is:

yˆi =

X

K

k=1

fk(xi), | fk ∈ F | (1)

where:

- K is the number of trees,
- fk represents an individual regression tree,
- F is the space of all possible trees.

Objective Function

The model is trained by minimizing a regularized objective function:

L =

Xn

i=1

l(yi

, yˆi) + X

K

k=1

Ω(fk) | (2)

where:

## - l(yi

, yˆi) is the loss function (e.g., squared error),
- Ω(fk) is the regularization term controlling model complexity.

Regularization Term

The regularization term for a tree is defined as:

Ω(f) = γT +

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
where:

- T is the number of leaves in the tree,
- wj is the weight of leaf j,
- γ controls the complexity (penalty on number of leaves),
- λ is the L2 regularization parameter.

Additive Training (Boosting)

XGBoost builds the model in an additive manner. At iteration t, the prediction is updated as:

yˆ

(t)
i = ˆy

(t−1)
i | + ft(xi) | (4)

To optimize efficiently, the loss is approximated using a second-order Taylor expansion:

L

(t) ≈

Xn

i=1

gift(xi) + 1
2

hif

2
t

(xi)

+ Ω(ft) | (5)

where:

gi =

∂l(yi
, yˆ

(t−1)
i

)

∂yˆ

(t−1)
i

, hi =

∂

2
l(yi
, yˆ

(t−1)
i

)

∂(ˆy

(t−1)
i

)

2

(6)

Optimal Leaf Weights

For a given tree structure, the optimal weight of leaf j is:

w

∗
j = −

P
i∈Ij

gi
P
i∈Ij

hi + λ

(7)

where Ij is the set of samples in leaf j.

Split Gain

The quality of a split is measured using the gain:

Gain =

1
2

"
(

P gL)

2
P hL + λ

+

(

P gR)

2
P hR + λ

−

(

P g)

2
P h + λ
− γ | (8)

where:

- L and R denote left and right child nodes,
- g and h are gradients and Hessians.

Summary

XGBoost improves prediction accuracy by:

- Sequentially adding trees to correct residual errors,
- Using second-order optimization (gradient + Hessian),
- Applying regularization to prevent overfitting,
- Optimizing tree splits using a gain-based criterion.
