vinay11hariharan-bit/IM-PULSE/3d_models/elec_box/cad_front_face.png

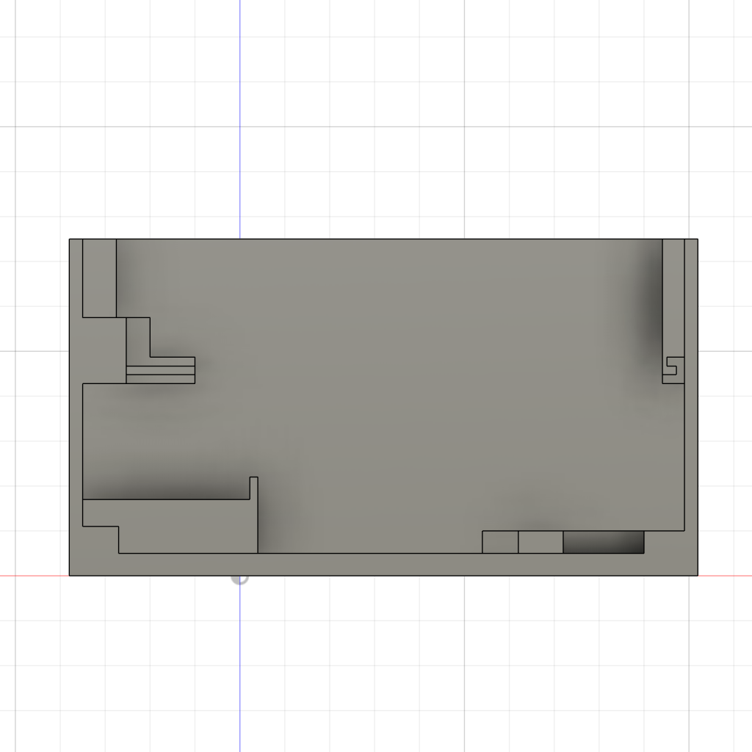
3d_models/elec_box/cad_front_face.png
