vinay11hariharan-bit/IM-PULSE/3d_models/elec_box/cad_right_face.png

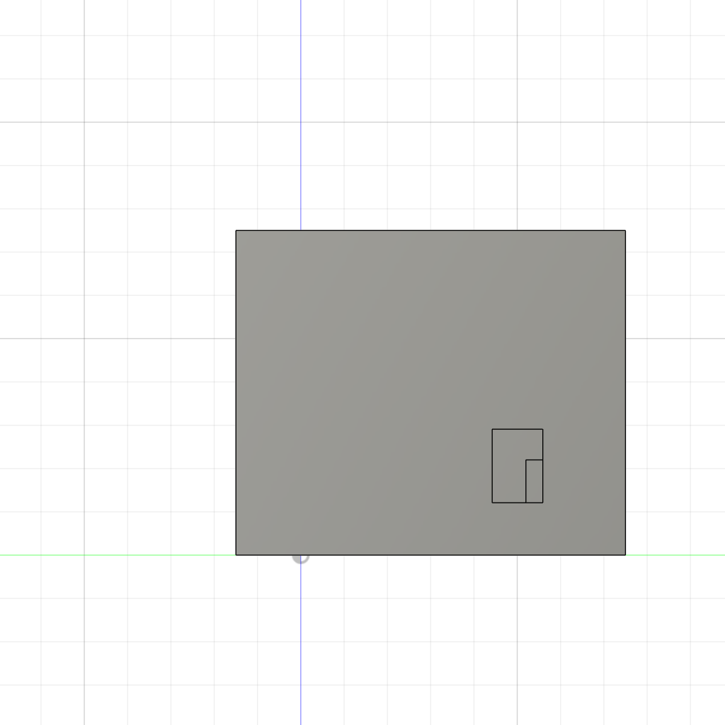
3d_models/elec_box/cad_right_face.png
