vinay11hariharan-bit/IM-PULSE/3d_models/elec_box/cad_top.png

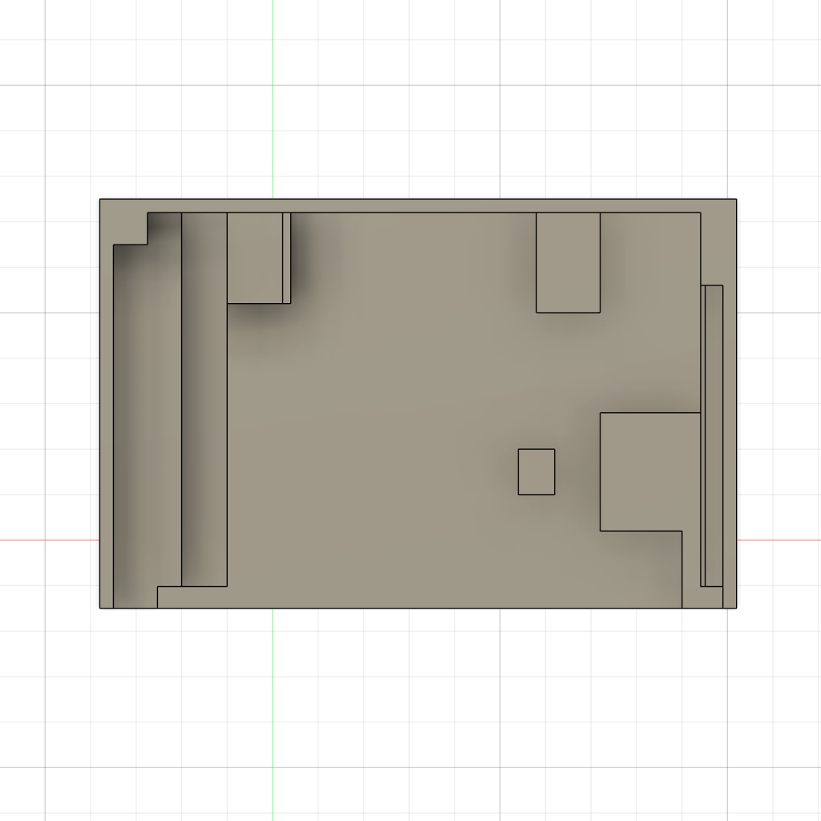
3d_models/elec_box/cad_top.png
