vinay11hariharan-bit/IM-PULSE/others/extra/BMS_documentation/BMS_flowchart.jpeg

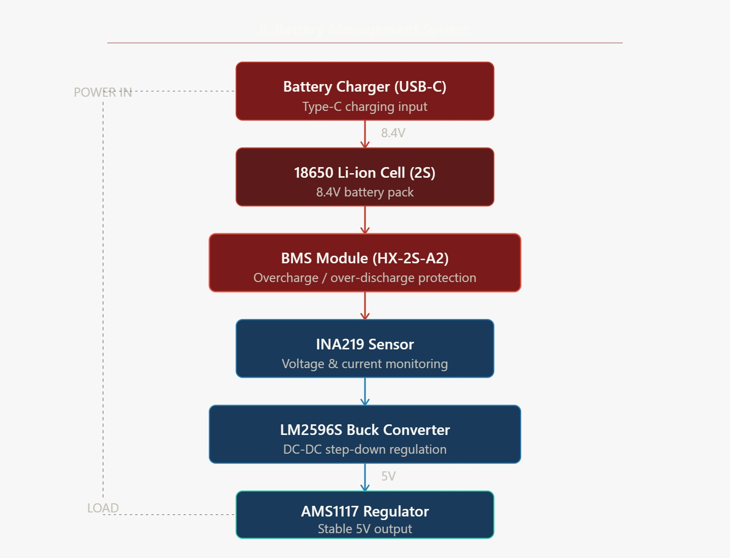
others/extra/BMS_documentation/BMS_flowchart.jpeg
