vinay11hariharan-bit/IM-PULSE/others/images/inter_pcb_connection.jpeg

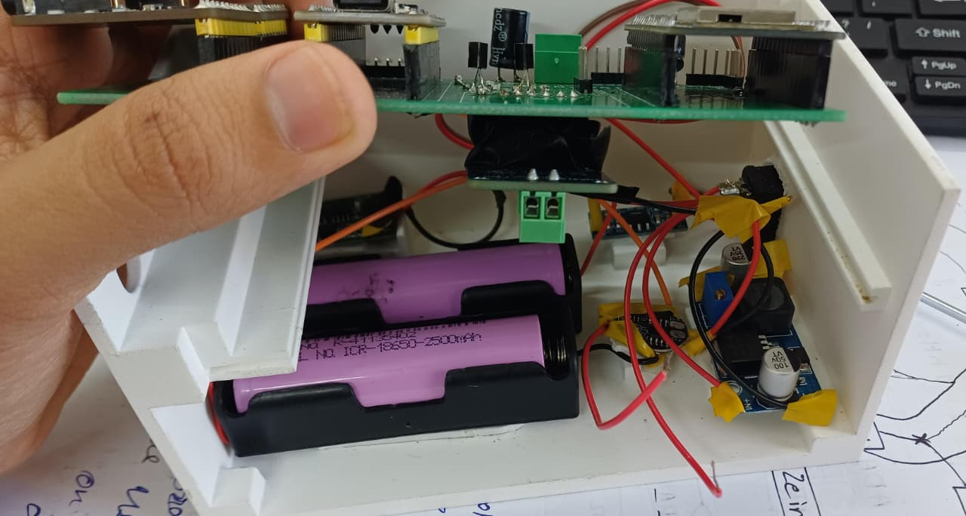
others/images/inter_pcb_connection.jpeg
