vinay11hariharan-bit/IM-PULSE/pcb/device_pcb/bottom_copper_layer.png

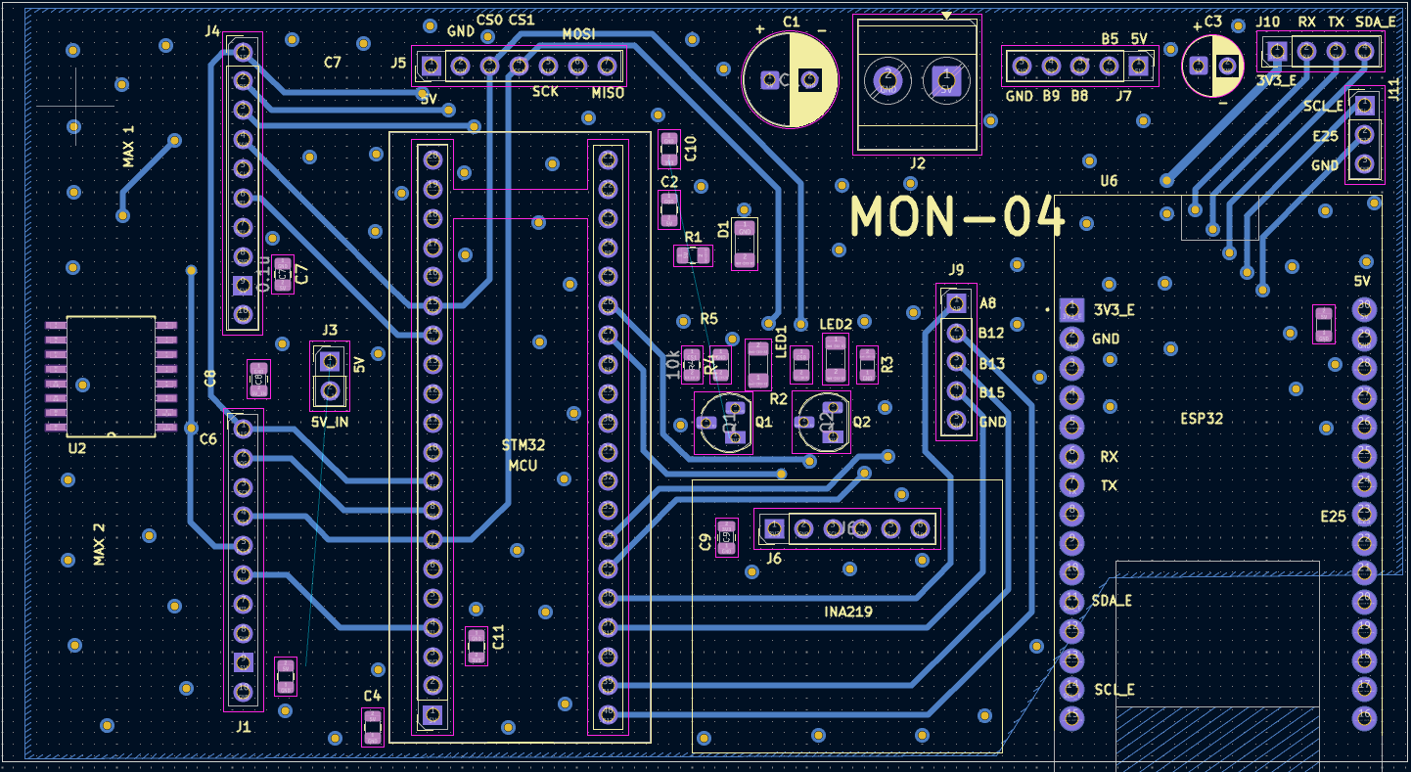
pcb/device_pcb/bottom_copper_layer.png
