vinay11hariharan-bit/IM-PULSE/pcb/device_pcb/front_copper_layer.png

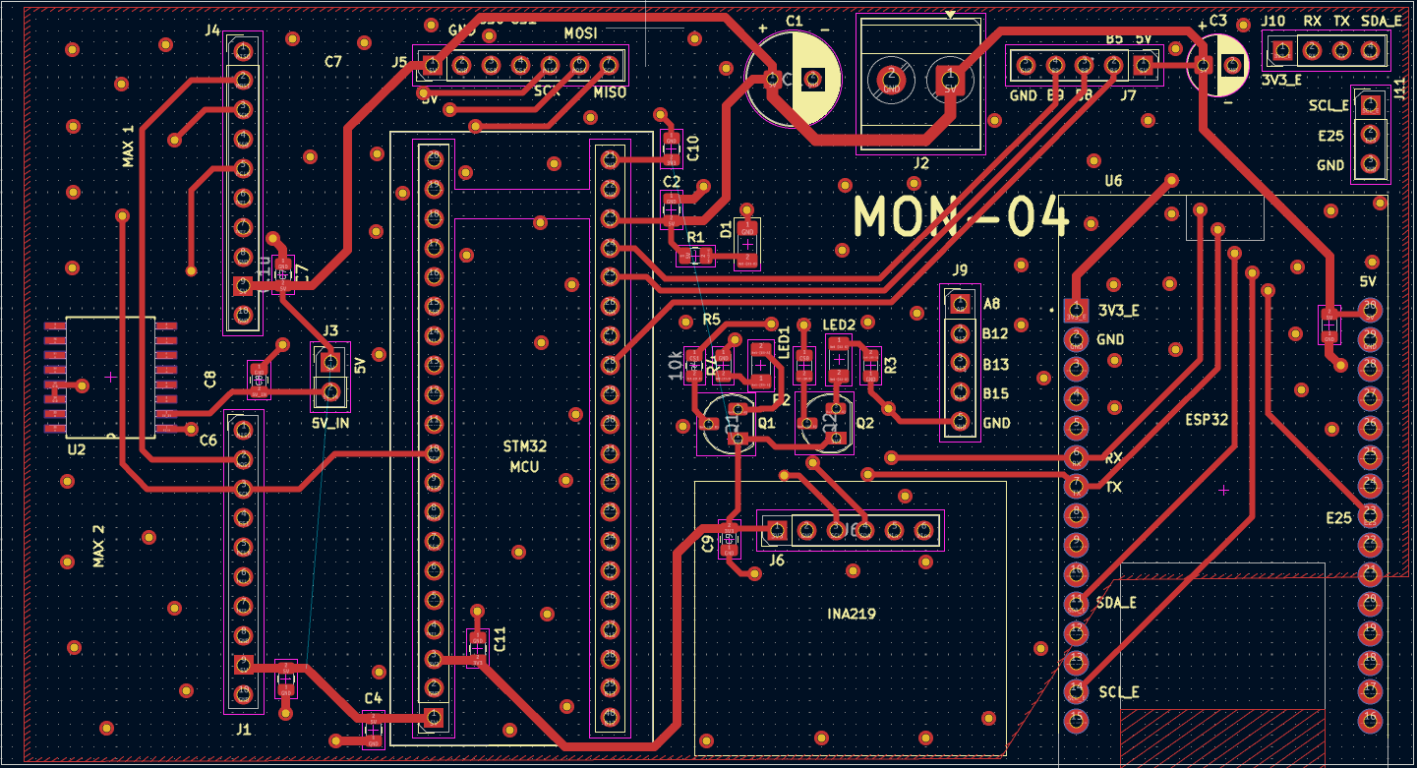
pcb/device_pcb/front_copper_layer.png
