vinay11hariharan-bit/IM-PULSE/pcb/device_pcb/pcb_back_3d.png

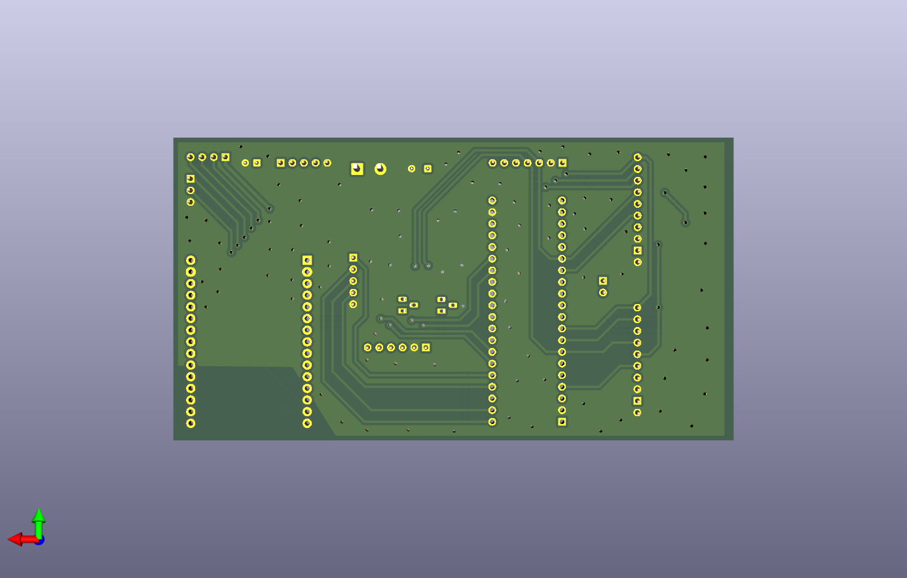
pcb/device_pcb/pcb_back_3d.png
