vinay11hariharan-bit/IM-PULSE/pcb/extras/BMS_circuit.jpeg

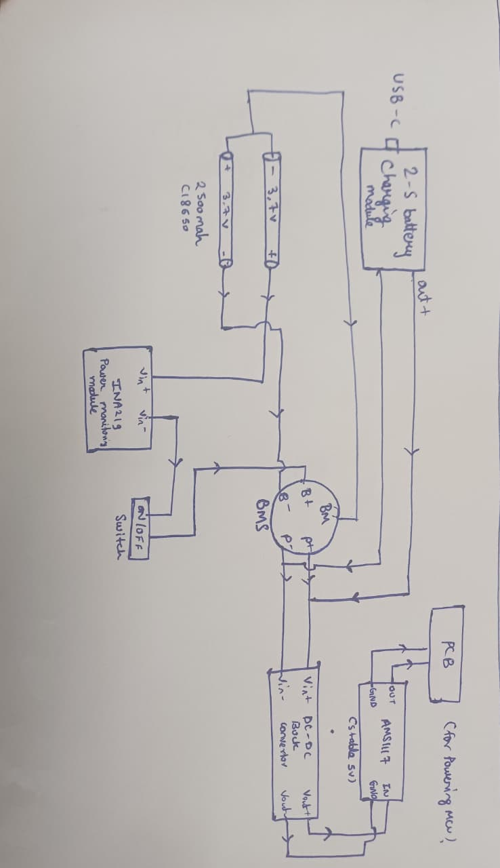
pcb/extras/BMS_circuit.jpeg
