vinay11hariharan-bit/IM-PULSE/others/extra/BMS_documentation/BMS_components.pdf

3.7 volts battery cell charger | 3.7 battery cell charger 2S 8.4V 2A 18650 Lithium Battery Charger Module TypeC

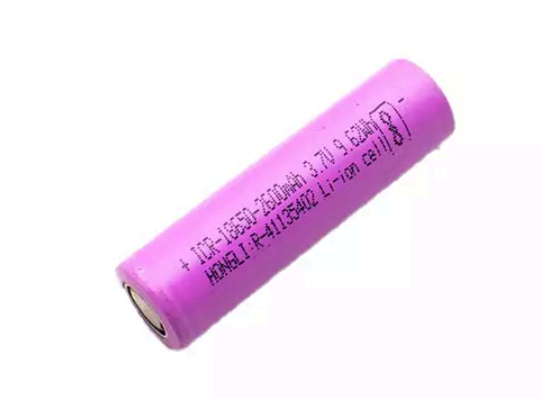
[picture p97: figure]

HX-2S-A2 Circular 2S 8.4V

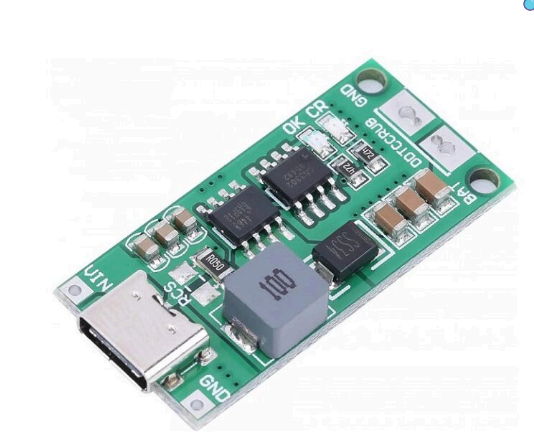
[picture p98: figure]

BMS 18650 Lithium Battery Protection Plate | INA219 Voltage and current sensing module

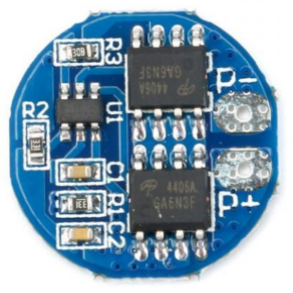
[picture p99: figure]
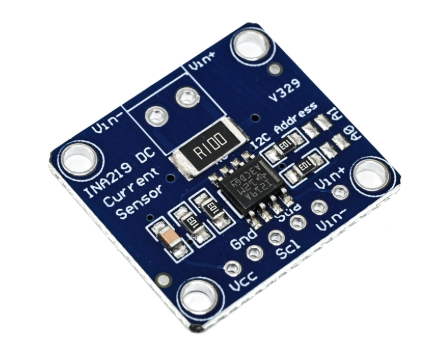
[picture p100: figure]
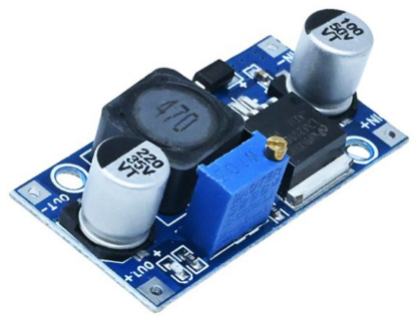
[picture p101: figure]
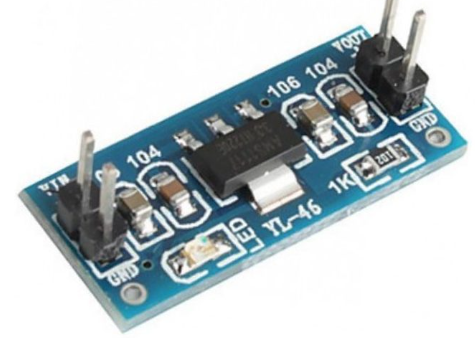
[picture p102: figure]

LM2596S- dc dcbuck convertor | AMS1117 5V stable voltage
