vinay11hariharan-bit/IM-PULSE/bom.xls

Component_name | Type | Quantity | Part No | Manufacturer | Cost (in Rs) | Description
2S Battery Charger | Module | 1 |  | Robu | 123 | used to charge two 2s battey cells
3.7 battery cell(2500 mah) | Consumable | 2 | 18650 | Wel | 116 | Use for powerering the device
2S 8.4V BMS 18650 | Module | 1 | HX-2S-A2 Circular | Robu | 56 | Used to protect the individual battery cells from overcharging, overdischarging and overcurrent
INA219 | Module | 1 |  | Robu | 99 | I2C Bi-Directional Current & Power Monitoring Module
DC-DC Buck Converter Power Supply | Module | 1 | LM2596S | Robu | 41 | use to bring down the voltage to around 6 volts
5V Step-Down Power Supply | Module | 1 | AMS1117 | Robu | 15 | For stable 5 volts
ON/OFF | Module | 1 |  | Mangaldeep | 30 | for turning on and off of final product
STM32 ARM Core Board(Black Pill) | Module | 1 | STM32F411CEU6 | Robu | 322 | Used for on board processing of the signals
ECG + Bio-impedance AFE | Module | 2 | PC-MED-0307 MAX30001 (Breakout Board) | ProtoCentral | 9990 | Used for demodulation and filtering of the signals
WIFI Bluetooth Networking Smart Component Development Board | Module | 1 | ESP-WROOM-32 | Robu | 395 | used for sending the health parameters value to the cloud
Surface Mount LED Yellow | IC | 2 | 1206 | Robu | 1.88 | debugging led's used for detecting communication between stm and max board
Pnp BJT | IC | 2 | 2N2907A | Robu | 12 | used for switched the led
Surface Mount LED Red | IC | 1 | XL-3216SURC-FB-XINGLIGHT | Robu | 2.5 | power on led on pcb
smd resistor(10k) | IC | 2 | 805 | WEL | 1.5
smd resistor(1k) | IC | 1 | 805 | WEL | 0.2
smd resistor(330) | IC | 2 | 805 | WEL | 0.4
smd 0.1uF capacitor | IC | 8 | 805 | WEL | 2
Through hole 470uF cap | Consumable | 1 |  | hubtronics | 4.71
Through hole 100uF cap | Consumable | 1 |  | kitsGuru | 3
