vinay11hariharan-bit/IM-PULSE/3d_models/elec_box/elec_box.stl

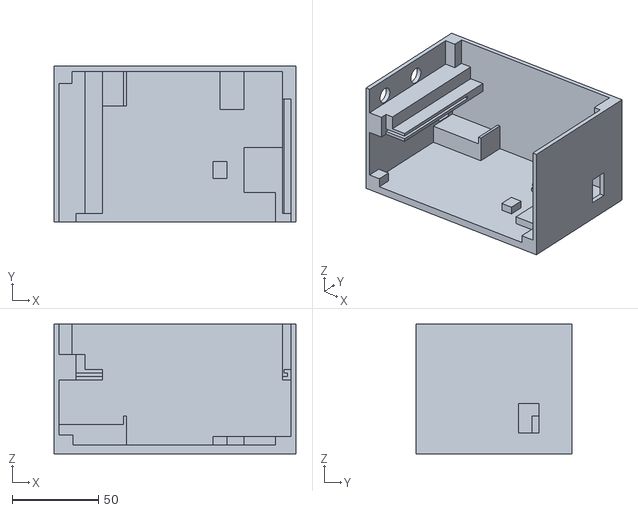
[picture p103: CAD file, 2026-10-24]
3d_models/elec_box/elec_box.stl
140.0 x 90.0 x 75.0
