vinay11hariharan-bit/IM-PULSE/3d_models/front_acrylic_plate/acrylic_side.dxf

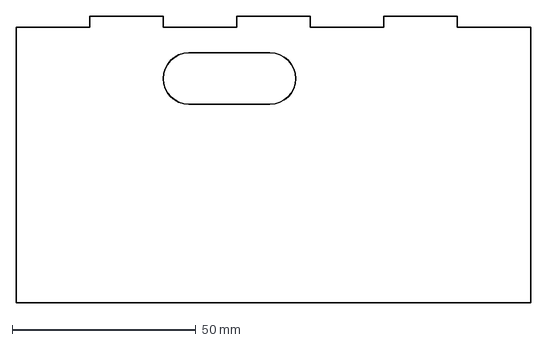
[picture p104: CAD file, 2026-10-24]
3d_models/front_acrylic_plate/acrylic_side.dxf
140.0 x 78.0 mm
