vinay11hariharan-bit/IM-PULSE/3d_models/top_acrylic_plate/acrylic_top_part.dxf

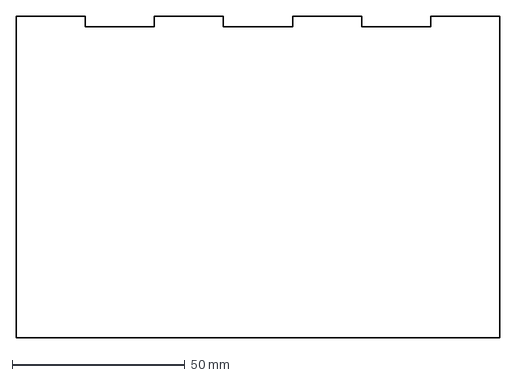
[picture p105: CAD file, 2026-10-24]
3d_models/top_acrylic_plate/acrylic_top_part.dxf
140.0 x 93.0 mm
