vinay11hariharan-bit/IM-PULSE/pcb/device_pcb/second_pcb.step

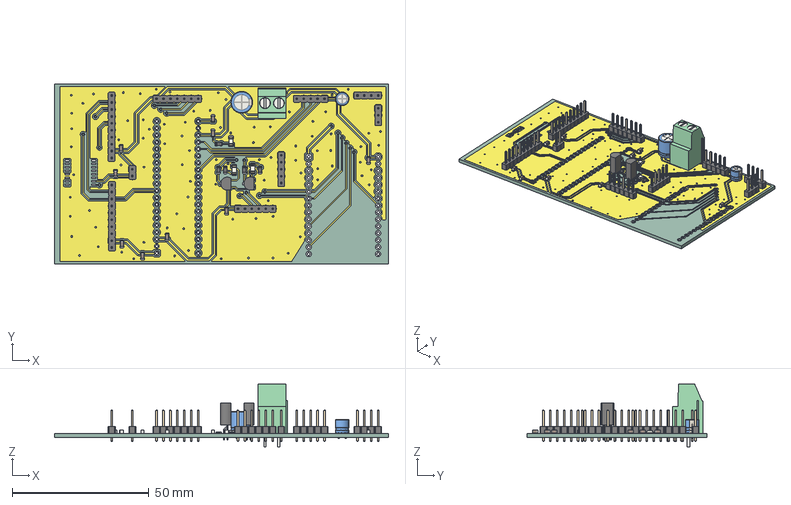
[picture p106: CAD file, 2026-10-24]
pcb/device_pcb/second_pcb.step
122.2 x 66.0 x 23.0 mm
LED_1206_3216Metric x 3
PinHeader_1x10_P2.54mm_Vertical x 2
PinHeader_1x02_P2.54mm_Vertical
PinHeader_1x07_P2.54mm_Vertical
R_0805_2012Metric x 5
C_0805_2012Metric x 9
PinHeader_1x06_P2.54mm_Vertical
TO-92L x 2
PinHeader_1x05_P2.54mm_Vertical x 2
PinHeader_1x03_P2.54mm_Vertical
CP_Radial_D8.0mm_P3.50mm
PinHeader_1x04_P2.54mm_Vertical
CP_Radial_D5.0mm_P2.50mm
TerminalBlock_Phoenix_MKDS-3-2-5.08_1x02_P5.08mm_Horizontal
second_pcb_copper
second_pcb_pad
second_pcb_via
second_pcb_PCB
