vinay11hariharan-bit/IM-PULSE/3d_models/elec_box/final_assembly.png

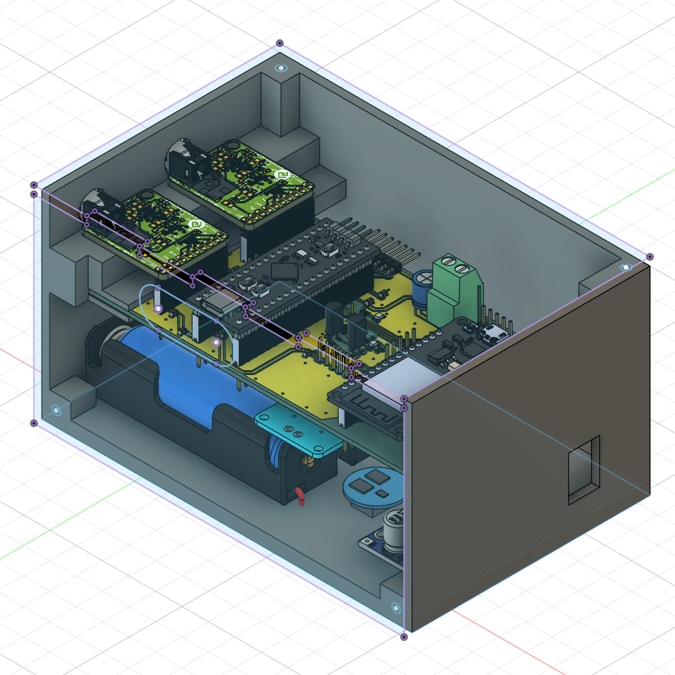
3d_models/elec_box/final_assembly.png
