vinay11hariharan-bit/IM-PULSE/others/images/BMS_wiring_case.jpeg

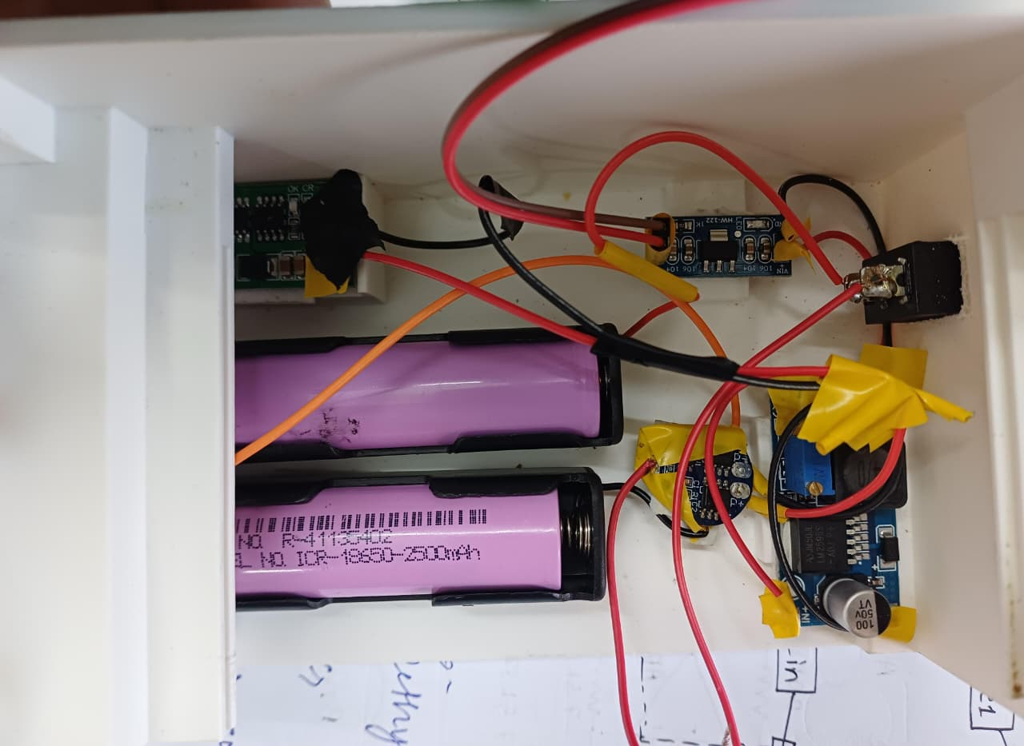
others/images/BMS_wiring_case.jpeg
