vinay11hariharan-bit/IM-PULSE/pcb/device_pcb/pcb_bottom_layer_print.pdf

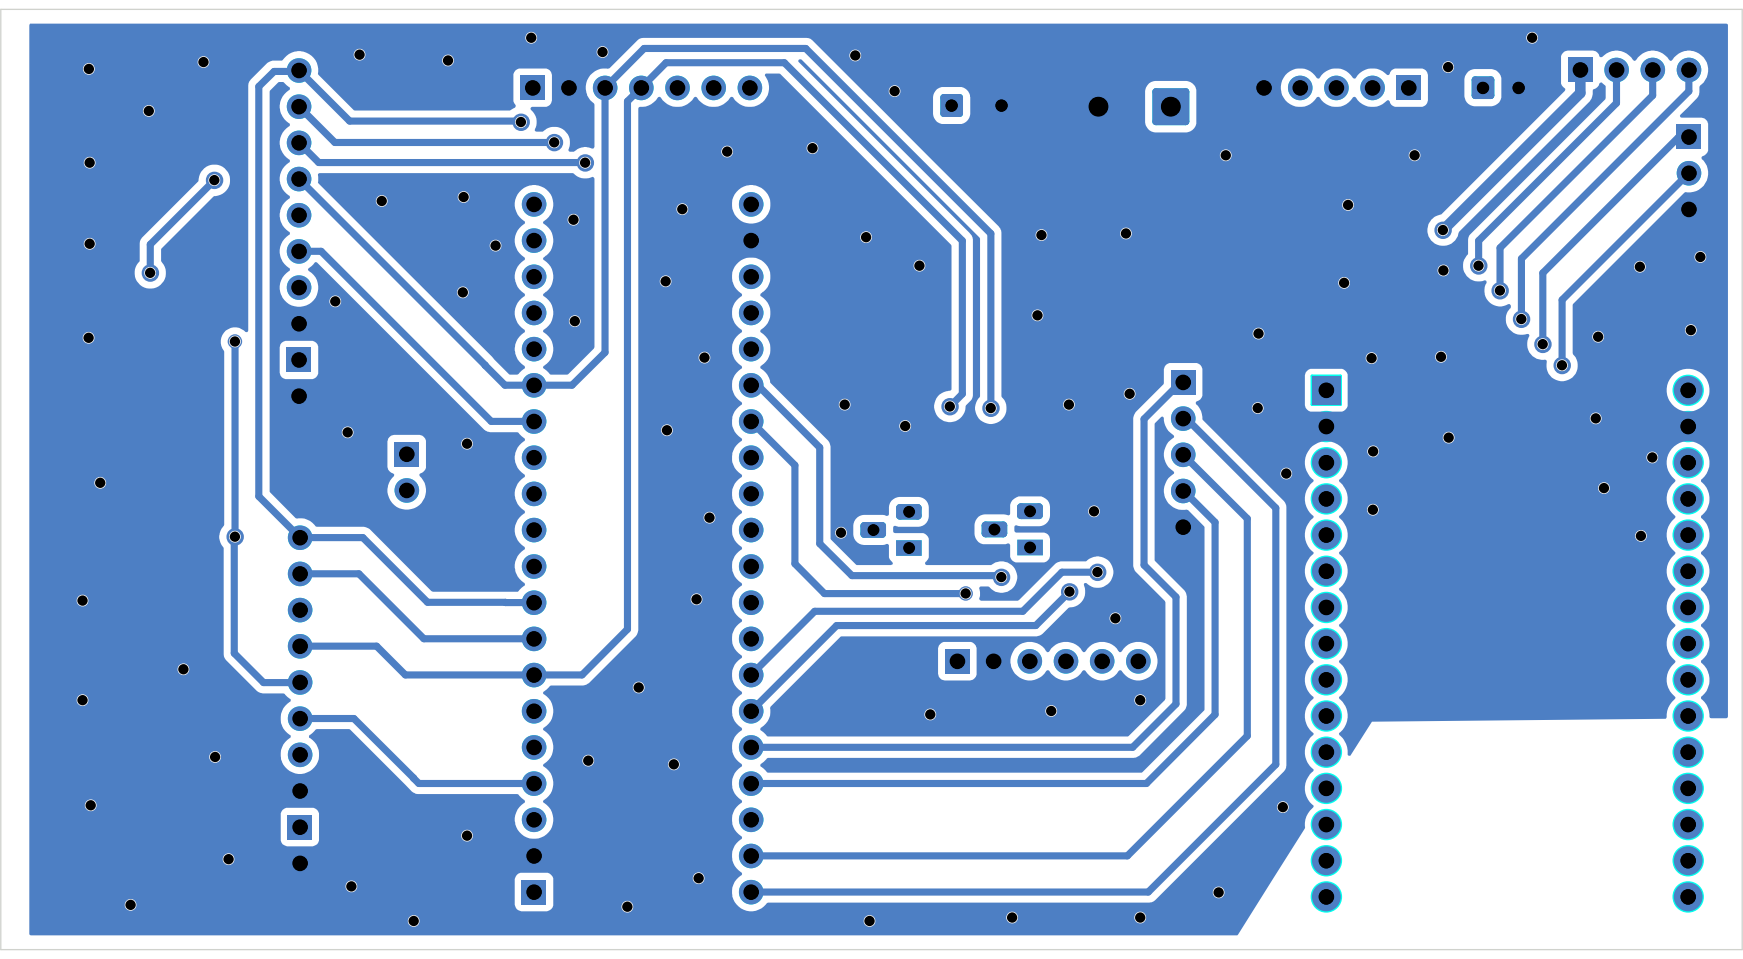
[picture p112: page 1]
