vinay11hariharan-bit/IM-PULSE/pcb/device_pcb/pcb_front_layer_print.pdf

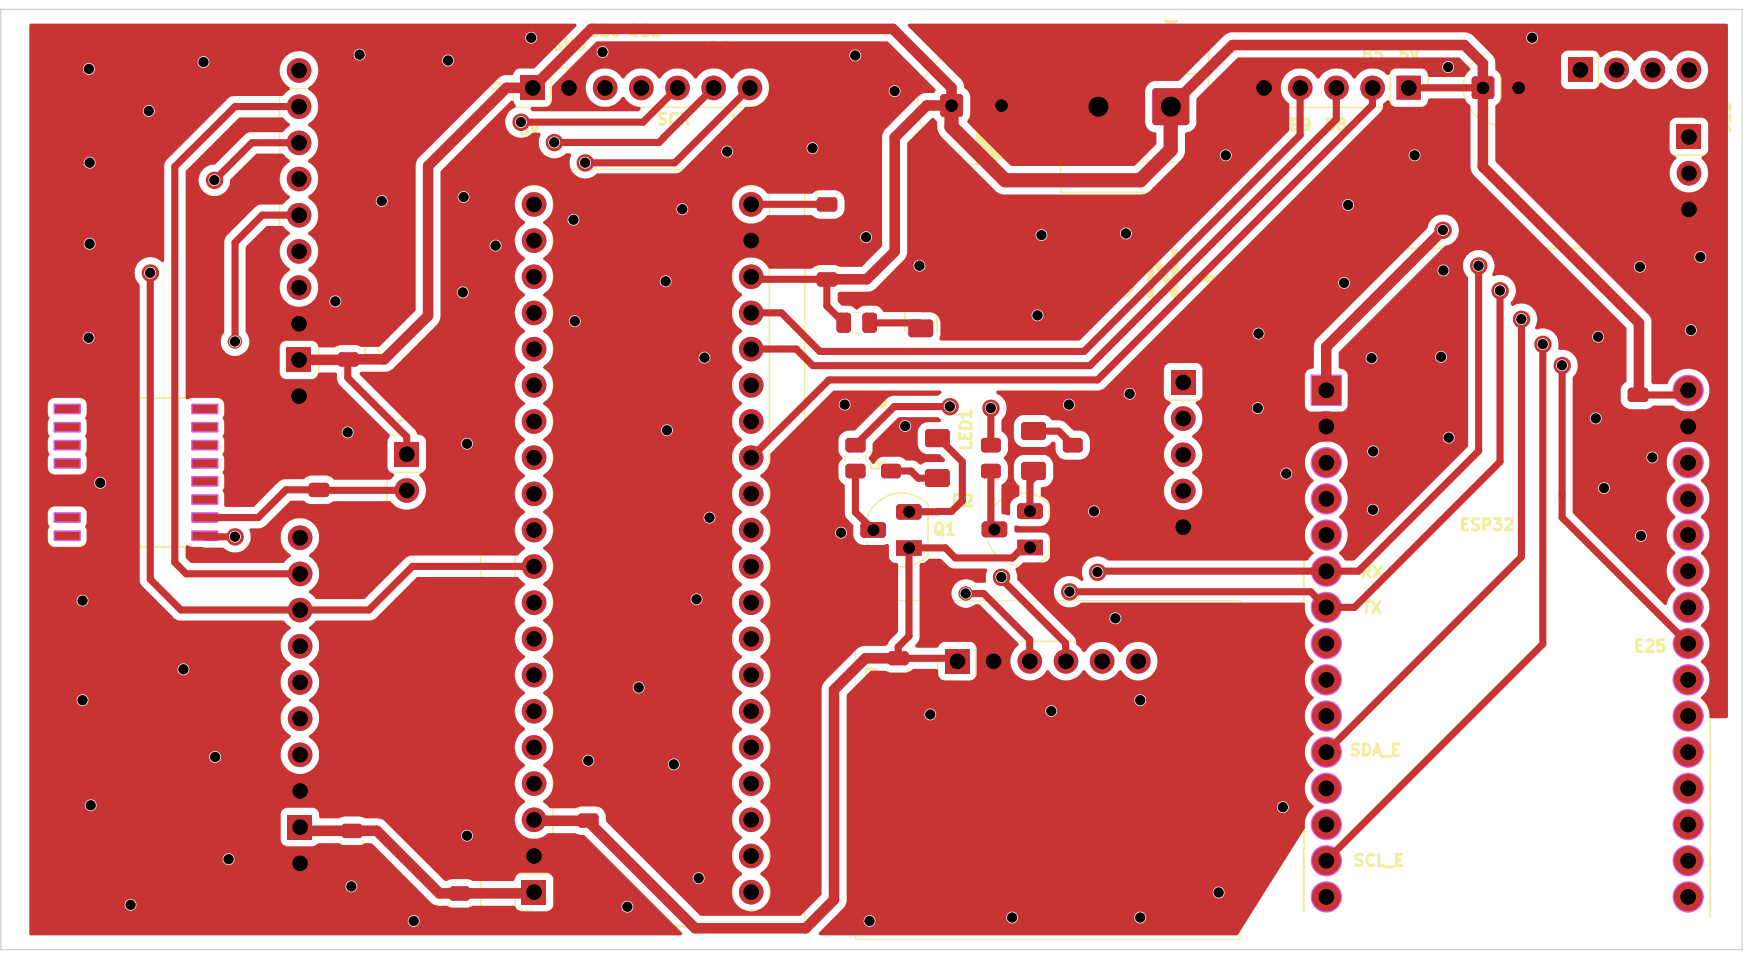
[picture p113: page 1]
