vinay11hariharan-bit/IM-PULSE/others/simulation/foot_detection_MATLAB.pdf

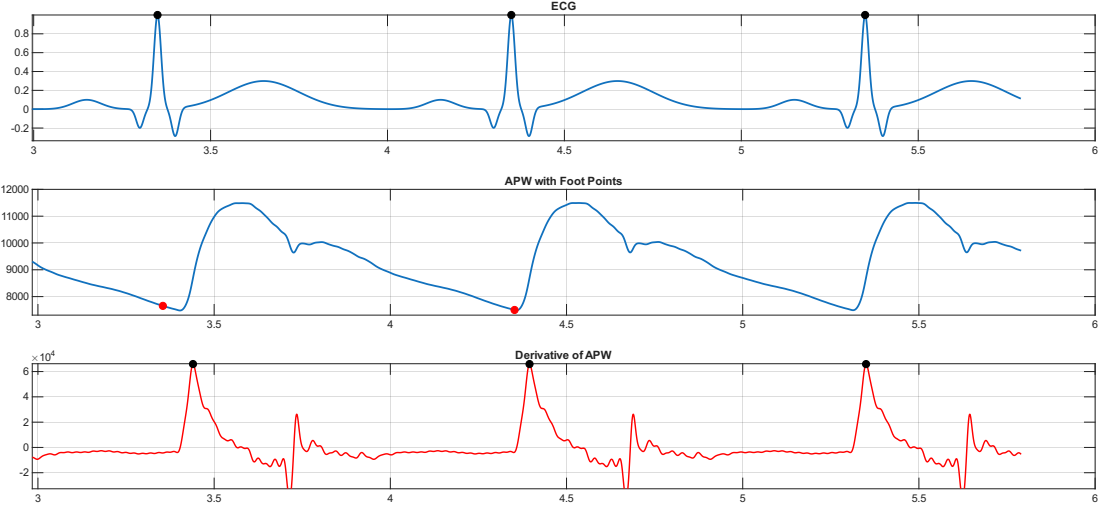
[picture p114: page 1]
wit; oin; riv; tiv
