vinay11hariharan-bit/IM-PULSE/pcb/device_pcb/second_pcb.kicad_pcb

## KiCad design pcb/device_pcb/second_pcb.kicad_pcb (2026-10-24)

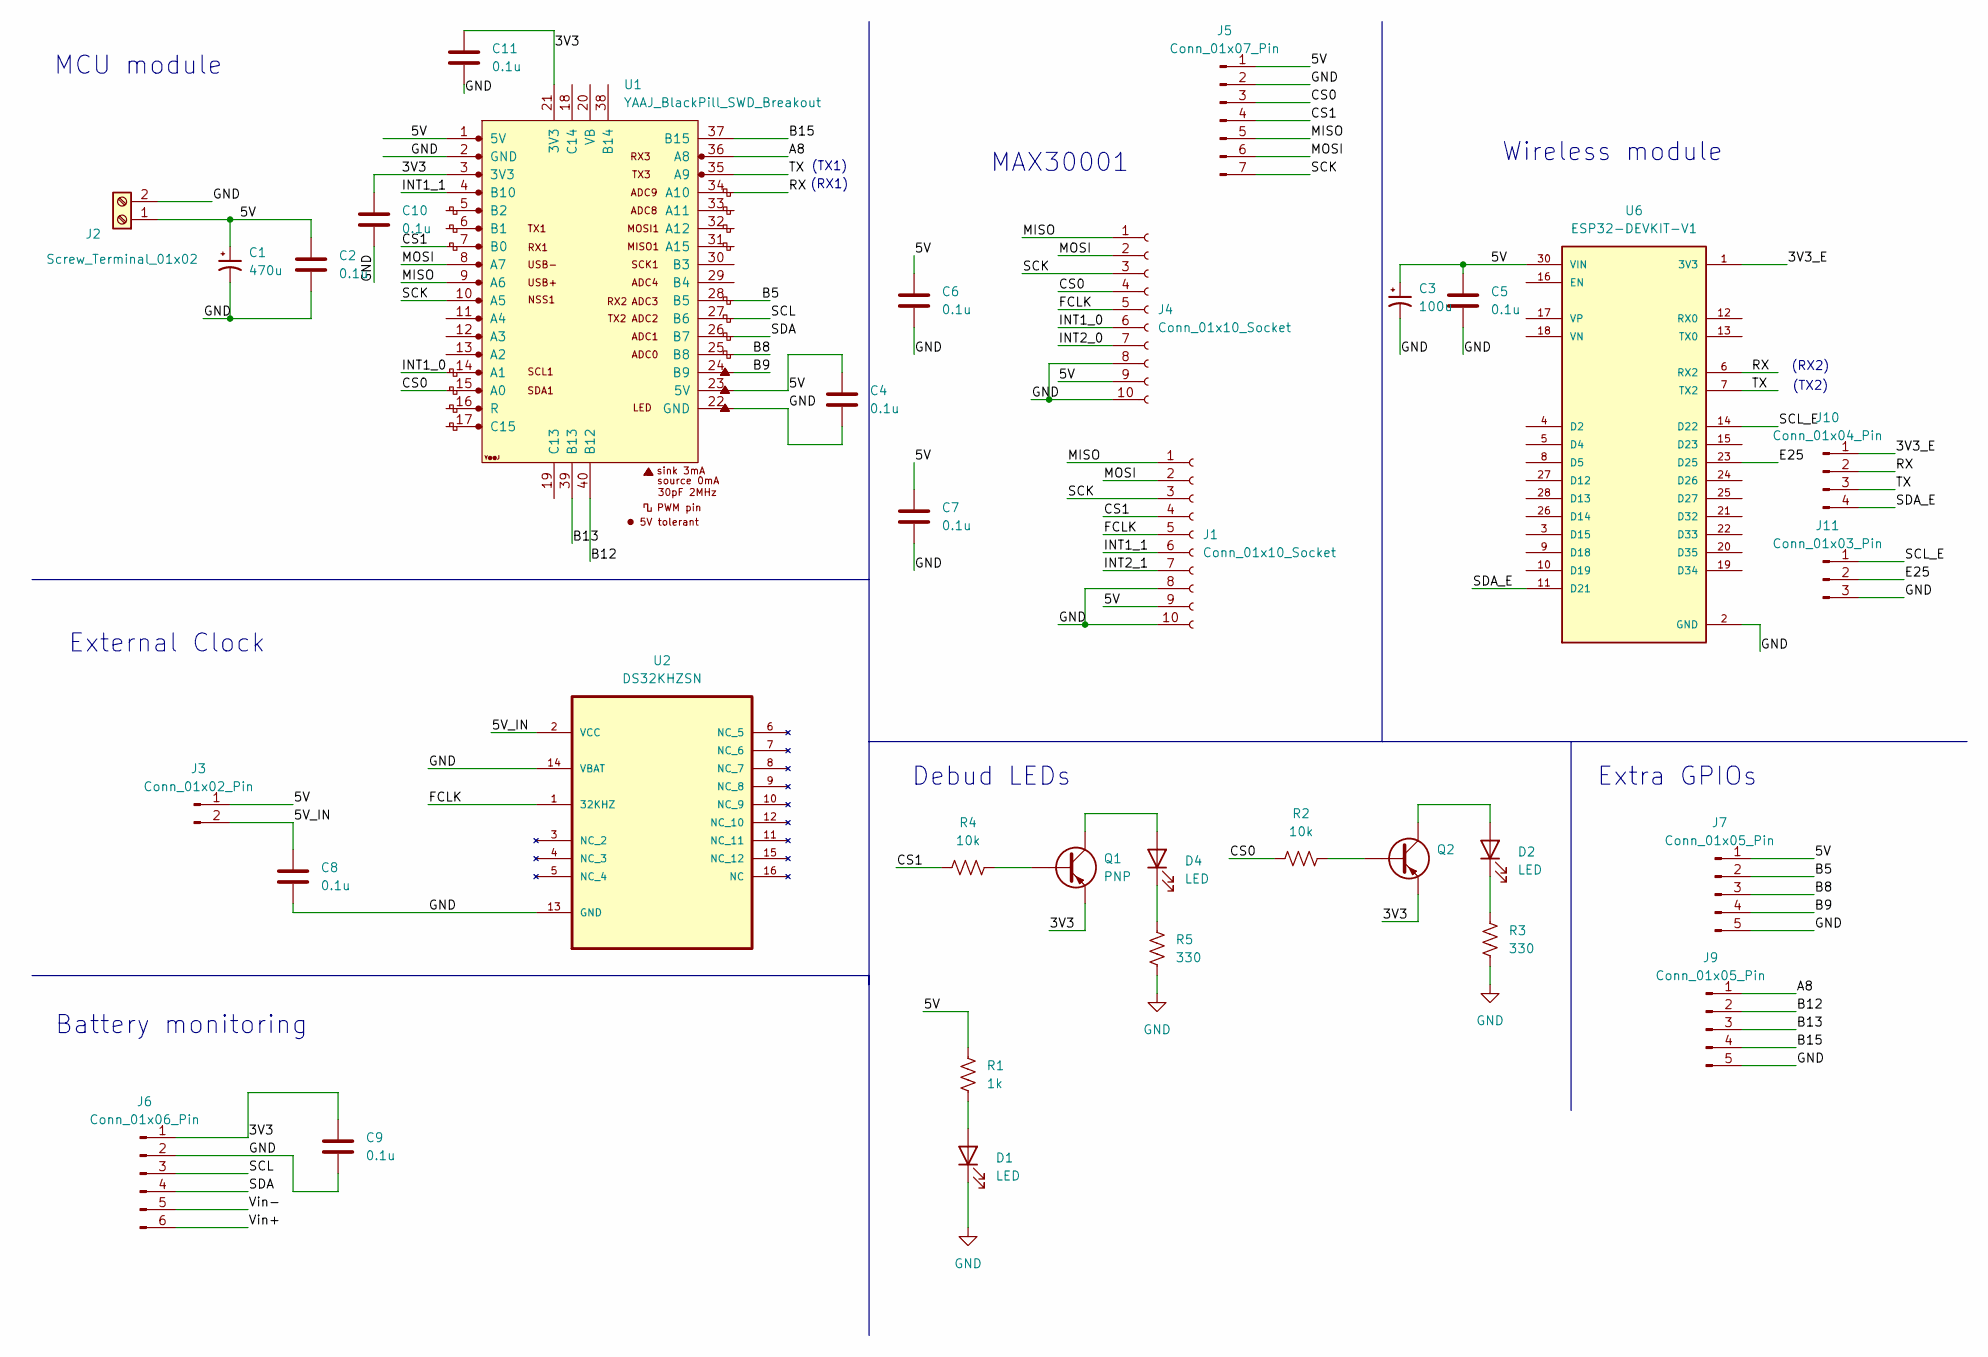
[picture p115: schematic second_pcb.kicad_sch]

Parts:
C1: 470u; CP_Radial_D8.0mm_P3.50mm
C2, C4, C5, C6, C7, C8, C9, C10, C11: 0.1u; C_0805_2012Metric
C3: 100u; CP_Radial_D5.0mm_P2.50mm
D1, D2, D4: LED; LED_1206_3216Metric
J1, J4: Conn_01x10_Socket; PinHeader_1x10_P2.54mm_Vertical
J2: Screw_Terminal_01x02; TerminalBlock_Phoenix_MKDS-3-2-5.08_1x02_P5.08mm_Horizontal
J3: Conn_01x02_Pin; PinHeader_1x02_P2.54mm_Vertical
J5: Conn_01x07_Pin; PinHeader_1x07_P2.54mm_Vertical
J6: Conn_01x06_Pin; PinHeader_1x06_P2.54mm_Vertical
J7, J9: Conn_01x05_Pin; PinHeader_1x05_P2.54mm_Vertical
J10: Conn_01x04_Pin; PinHeader_1x04_P2.54mm_Vertical
J11: Conn_01x03_Pin; PinHeader_1x03_P2.54mm_Vertical
Q1, Q2: PNP; TO-92L_HandSolder_modified
R1: 1k; R_0805_2012Metric
R2, R4: 10k; R_0805_2012Metric
R3, R5: 330; R_0805_2012Metric
U1: YAAJ_BlackPill_SWD_Breakout; YAAJ_BluePill_SWD_1
U2: DS32KHZSN; SOIC127P1034X267-16N; MPN DS32KHZSN#
U6: ESP32-DEVKIT-V1; MODULE_ESP32_DEVKIT_V1_modified; PARTREV N/A

Connections:
/3V3: C9.2, C10.2, C11.2, J6.1, Q1.1 (E), Q2.1 (E), U1.3 (3V3), U1.21 (3V3)
/3V3_E: J10.1, U6.1 (3V3)
/5V: C1.1, C2.2, C3.1, C4.2, C5.2, C6.2, C7.2, J1.9, J2.1, J3.1, J4.9, J5.1, J7.1, R1.1, U1.1 (5V), U1.23 (5V), U6.30 (VIN)
/5V_IN: C8.2, J3.2, U2.2 (VCC)
/A8: J9.1, U1.36 (A8)
/B5: J7.2, U1.28 (B5)
/B8: J7.3, U1.25 (B8)
/B9: J7.4, U1.24 (B9)
/B12: J9.2, U1.40 (B12)
/B13: J9.3, U1.39 (B13)
/B15: J9.4, U1.37 (B15)
/CS0: J4.4, J5.3, R2.1, U1.15 (A0)
/CS1: J1.4, J5.4, R4.1, U1.7 (B0)
/E25: J11.2, U6.23 (D25)
/FCLK: J1.5, J4.5, U2.1 (32KHZ)
/INT1_0: J4.6, U1.14 (A1)
/INT1_1: J1.6, U1.4 (B10)
/INT2_0: J4.7
/INT2_1: J1.7
/MISO: J1.1, J4.1, J5.5, U1.9 (A6)
/MOSI: J1.2, J4.2, J5.6, U1.8 (A7)
/RX: J10.2, U1.34 (A10), U6.6 (RX2)
/SCK: J1.3, J4.3, J5.7, U1.10 (A5)
/SCL: J6.3, U1.27 (B6)
/SCL_E: J11.1, U6.14 (D22)
/SDA: J6.4, U1.26 (B7)
/SDA_E: J10.4, U6.11 (D21)
/TX: J10.3, U1.35 (A9), U6.7 (TX2)
/Vin+: J6.6
/Vin-: J6.5
GND: C1.2, C2.1, C3.2, C4.1, C5.1, C6.1, C7.1, C8.1, C9.1, C10.1, C11.1, D1.1 (K), J1.8, J1.10, J2.2, J4.8, J4.10, J5.2, J6.2, J7.5, J9.5, J11.3, R3.1, R5.1, U1.2 (GND), U1.22 (GND), U2.13 (GND), U2.14 (VBAT), U6.2 (GND), U6.29 (GND)
unnamed: D1.2 (A), R1.2
unnamed: D2.2 (A), Q2.3 (C)
unnamed: D2.1 (K), R3.2
unnamed: D4.2 (A), Q1.3 (C)
unnamed: D4.1 (K), R5.2
unnamed: Q1.2 (B), R4.2
unnamed: Q2.2 (B), R2.2

Notes on the sheet:
Debud LEDs
External Clock
Wireless module
Battery monitoring
MCU module
(RX2)
Extra GPIOs
MAX30001
(TX2)
(TX1)
(RX1)

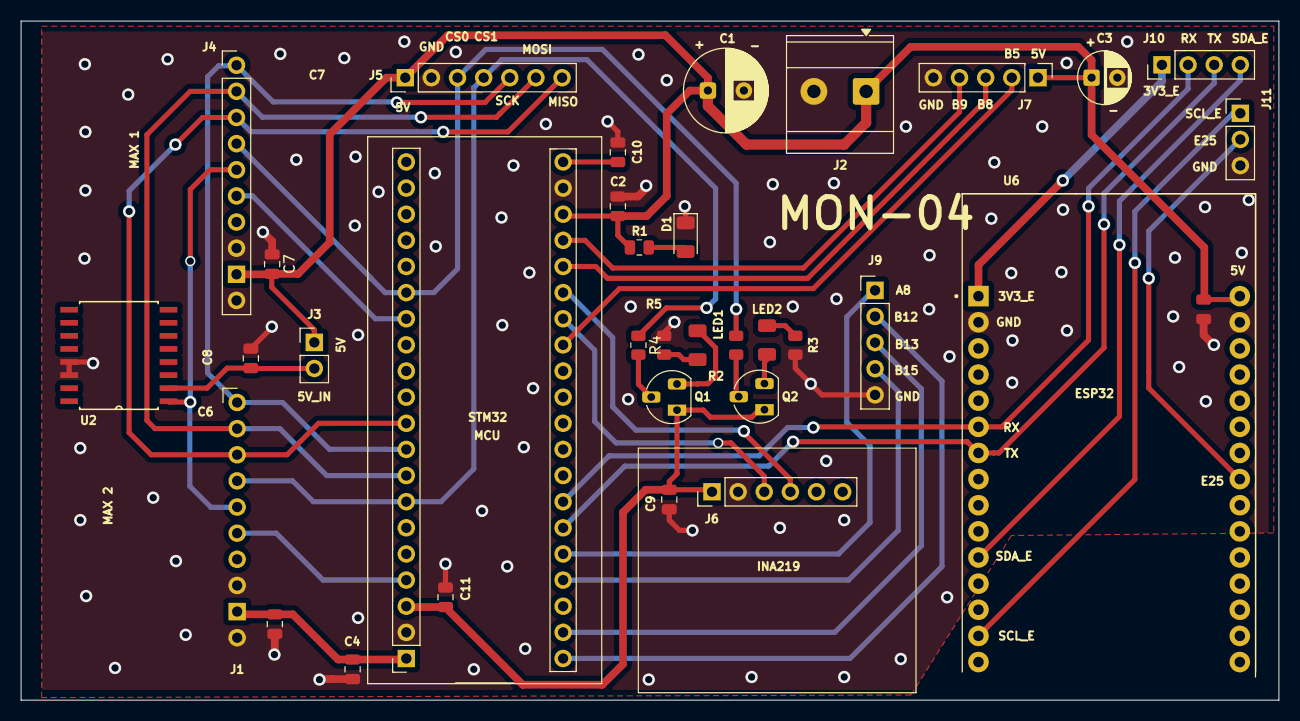
[picture p116: board second_pcb.kicad_pcb from above]

Board: 2 copper layers, 122.2 x 66.0 mm, 34 parts (0 on the bottom side), 34 nets.
