vinay11hariharan-bit/IM-PULSE/(commit log)

2026-10-24 Import IM-PULSE EDL project as submitted
    [acrylic_side.dxf, acrylic_top_part.dxf, bom.xls, elec_box.stl, second_pcb.kicad_pcb, second_pcb.kicad_sch, second_pcb.step]
2026-10-24 Clean up repository after course submission
    - New README: project summary, system diagram, specs, layout, quick start,
    build photos; team write-up kept as is.
    - Remove GitHub Classroom files (badge, submission instructions, workflow).
    - Remove KiCad per-user/lock/cache files and add .gitignore.
    - Rename source folders without spaces (src/stm32_blackpill,
    src/esp32_bridge, src/host_app) and name each sketch after its folder
    so the Arduino IDE opens it directly.
    - Add src/host_app/requirements.txt.
    - Fix user manual paths.
    [esp32_bridge.ino, stm32_blackpill.ino]
